zephray/Bric/pcb/pcb.kicad_pcb

## KiCad design pcb/pcb.kicad_pcb (2020-07-26)

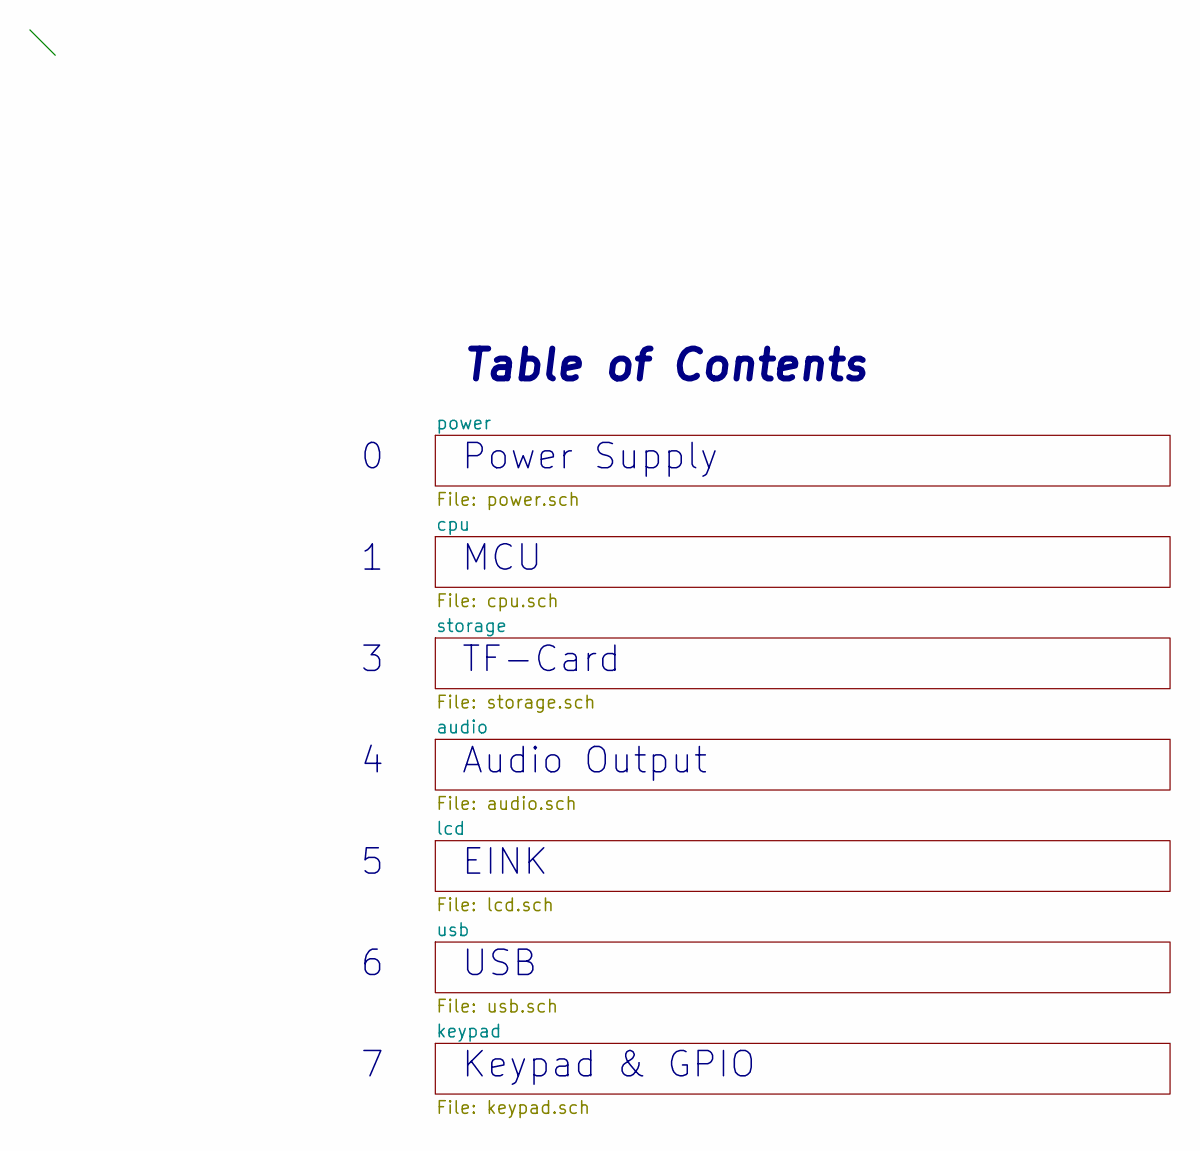
[picture p1: schematic pcb.sch, Bric]

Notes on the sheet:
MCU
EINK
TF-Card
Table of Contents
Power Supply
Audio Output
Keypad & GPIO
USB

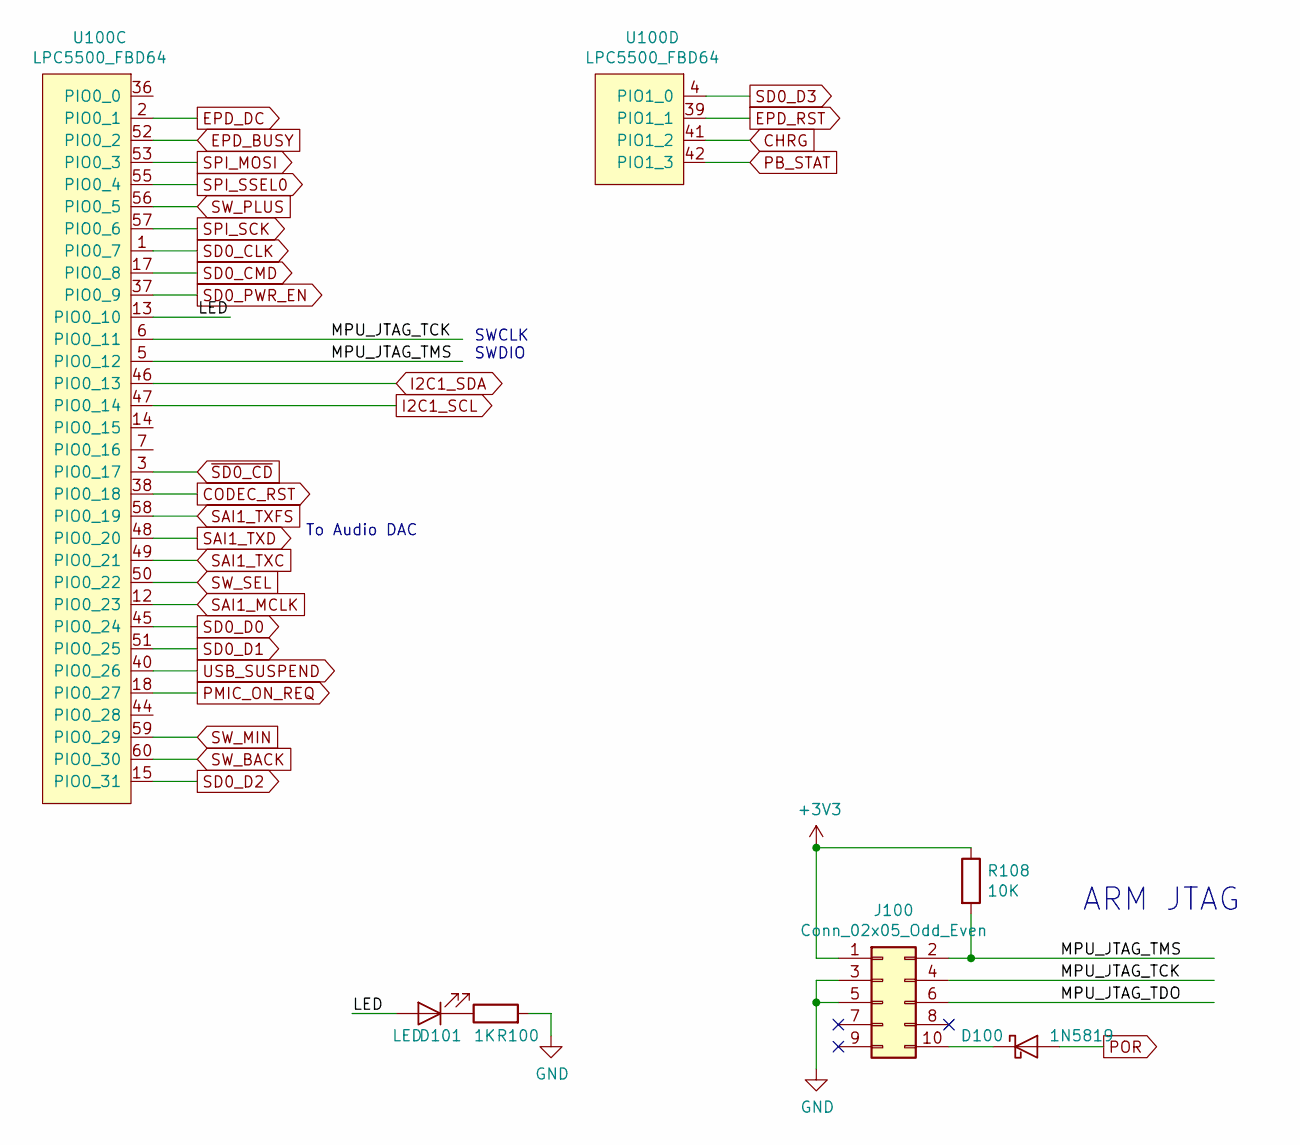
[picture p2: schematic cpu.sch, Bric]

Parts:
D100: 1N5819; D_SOD-123
D101: LED; LED_0603_1608Metric
J100: Conn_02x05_Odd_Even; PinHeader_2x05_P1.27mm_Vertical_SMD
R100: 1K; R_0603_1608Metric
R108: 10K; R_0603_1608Metric
U100: LPC5500_FBD64; LQFP-64-1EP_10x10mm_P0.5mm_EP5x5mm_ThermalVias

Connections:
/cpu/LED: D101.2 (A), U100.13 (PIO0_10)
/cpu/MPU_JTAG_TCK: J100.4, U100.6 (PIO0_11)
/cpu/MPU_JTAG_TMS: J100.2, R108.2, U100.5 (PIO0_12)
CHRG: U100.41 (PIO1_2); also elsewhere on the board
CODEC_RST: U100.38 (PIO0_18); also elsewhere on the board
EPD_BUSY: U100.52 (PIO0_2); also elsewhere on the board
EPD_DC: U100.2 (PIO0_1); also elsewhere on the board
EPD_RST: U100.39 (PIO1_1); also elsewhere on the board
I2C1_SCL: U100.47 (PIO0_14); also elsewhere on the board
I2C1_SDA: U100.46 (PIO0_13); also elsewhere on the board
unnamed: D100.1 (K), J100.10
unnamed: D101.1 (K), R100.1
PB_STAT: U100.42 (PIO1_3); also elsewhere on the board
PMIC_ON_REQ: U100.18 (PIO0_27); also elsewhere on the board
POR: D100.2 (A); also elsewhere on the board
SAI1_MCLK: U100.12 (PIO0_23); also elsewhere on the board
SAI1_TXC: U100.49 (PIO0_21); also elsewhere on the board
SAI1_TXD: U100.48 (PIO0_20); also elsewhere on the board
SAI1_TXFS: U100.58 (PIO0_19); also elsewhere on the board
SD0_CLK: U100.1 (PIO0_7); also elsewhere on the board
SD0_CMD: U100.17 (PIO0_8); also elsewhere on the board
SD0_D0: U100.45 (PIO0_24); also elsewhere on the board
SD0_D1: U100.51 (PIO0_25); also elsewhere on the board
SD0_D2: U100.15 (PIO0_31); also elsewhere on the board
SD0_D3: U100.4 (PIO1_0); also elsewhere on the board
SPI_MOSI: U100.53 (PIO0_3); also elsewhere on the board
SPI_SCK: U100.57 (PIO0_6); also elsewhere on the board
SPI_SSEL0: U100.55 (PIO0_4); also elsewhere on the board
SW_BACK: U100.60 (PIO0_30); also elsewhere on the board
SW_MIN: U100.59 (PIO0_29); also elsewhere on the board
SW_PLUS: U100.56 (PIO0_5); also elsewhere on the board
SW_SEL: U100.50 (PIO0_22); also elsewhere on the board
USB_SUSPEND: U100.40 (PIO0_26); also elsewhere on the board
~SD0_CD: U100.3 (PIO0_17); also elsewhere on the board

Notes on the sheet:
ARM JTAG
To Audio DAC
SWCLK SWDIO

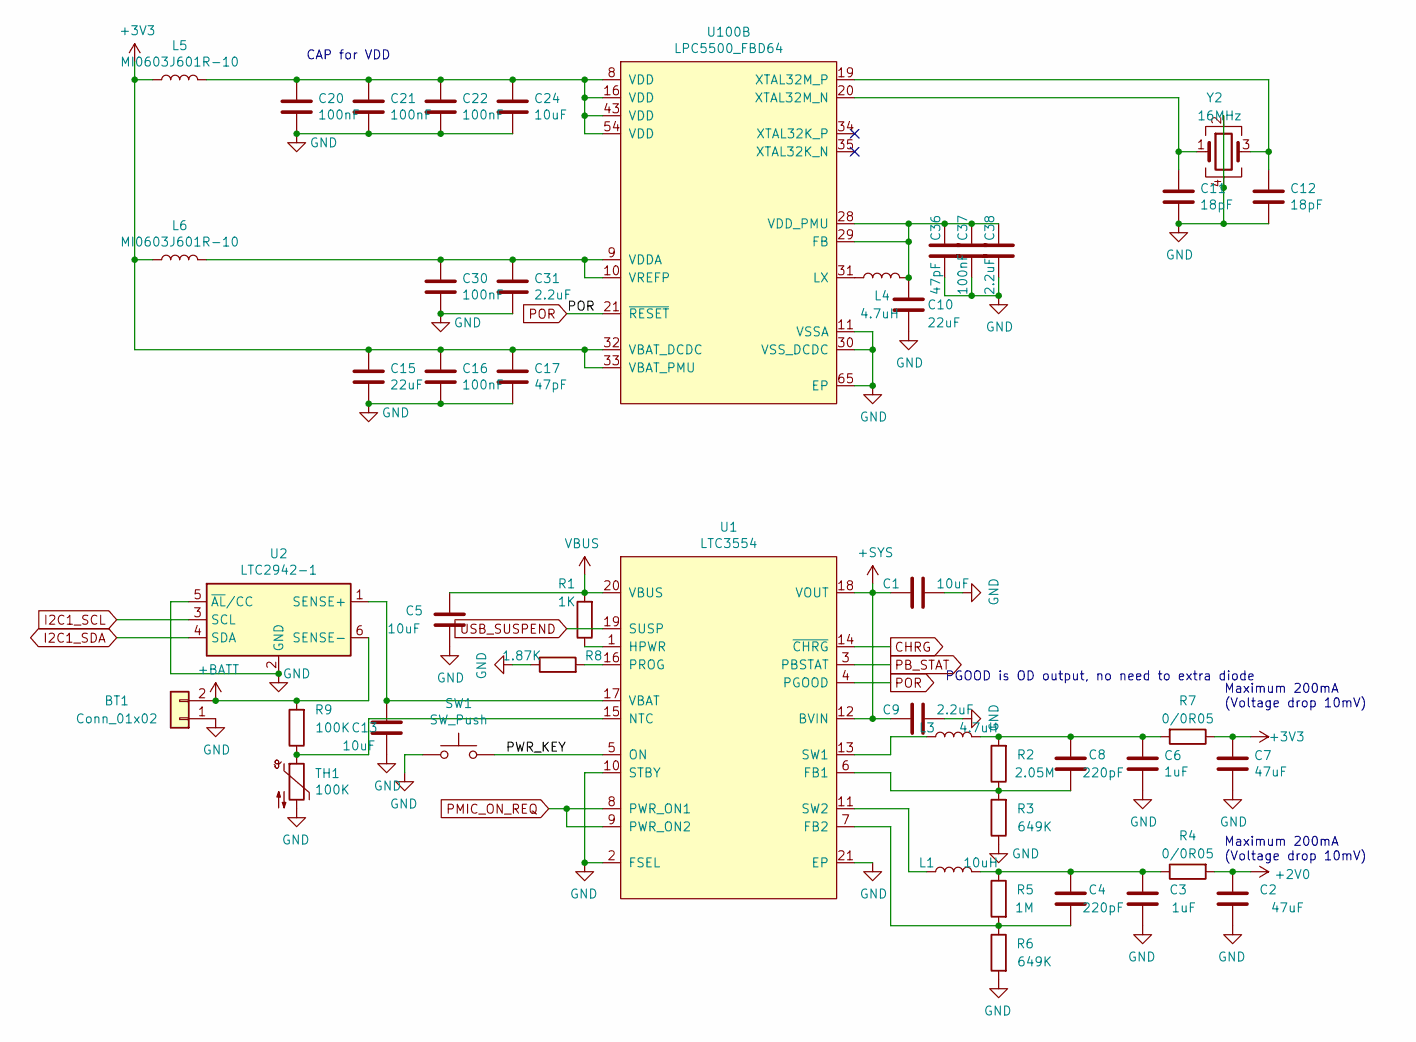
[picture p3: schematic power.sch, Bric]

Parts:
BT1: Conn_01x02; Molex_PicoBlade_53261-0271_1x02-1MP_P1.25mm_Horizontal
C1, C5, C13, C24: 10uF; C_0603_1608Metric
C2, C7: 47uF; C_0805_2012Metric
C3, C6: 1uF; C_0402_1005Metric
C4, C8: 220pF; C_0402_1005Metric
C9, C31, C38: 2.2uF; C_0402_1005Metric
C10, C15: 22uF; C_0603_1608Metric
C11, C12: 18pF; C_0402_1005Metric
C16, C20, C21, C22, C30, C37: 100nF; C_0402_1005Metric
C17, C36: 47pF; C_0402_1005Metric
L1: 10uH; L_Vishay_IHLP-1212
L3, L4: 4.7uH; L_Vishay_IHLP-1212
L5, L6: MI0603J601R-10; L_0603_1608Metric
R1: 1K; R_0603_1608Metric
R2: 2.05M; R_0603_1608Metric
R3, R6: 649K; R_0603_1608Metric
R4, R7: 0/0R05; R_0805_2012Metric
R5: 1M; R_0603_1608Metric
R8: 1.87K; R_0603_1608Metric
R9: 100K; R_0603_1608Metric
SW1: SW_Push; SW_SPST_EVQP7C
TH1: 100K; R_0603_1608Metric
U1: LTC3554; VQFN-20-1EP_3x3mm_P0.4mm_EP1.7x1.7mm_ThermalVias
U2: LTC2942-1; DFN-6-1EP_3x2mm_P0.5mm_EP1.65x1.35mm
U100: LPC5500_FBD64; LQFP-64-1EP_10x10mm_P0.5mm_EP5x5mm_ThermalVias
Y2: 16MHz; Oscillator_SMD_Abracon_ASE-4Pin_3.2x2.5mm

Connections:
+2V0: C2.1, R4.2; also elsewhere on the board
+BATT: BT1.2, R9.2, U2.6 (SENSE-)
+SYS: C1.2, C9.2, U1.12 (BVIN), U1.18 (VOUT); also elsewhere on the board
/power/PWR_KEY: SW1.2, U1.5 (ON)
CHRG: U1.14 (~CHRG); also elsewhere on the board
I2C1_SCL: U2.3 (SCL); also elsewhere on the board
I2C1_SDA: U2.4 (SDA); also elsewhere on the board
unnamed: C3.1, C4.1, L1.1, R4.1, R5.1
unnamed: C4.2, R5.2, R6.1, U1.7 (FB2)
unnamed: C6.1, C8.1, L3.2, R2.2, R7.2
unnamed: C8.2, R2.1, R3.2, U1.6 (FB1)
unnamed: C10.1, C36.1, C37.1, C38.1, L4.2, U100.28 (VDD_PMU), U100.29 (FB)
unnamed: C11.1, U100.20 (XTAL32M_N), Y2.1
unnamed: C12.1, U100.19 (XTAL32M_P), Y2.3
unnamed: C13.1, U1.17 (VBAT), U2.1 (SENSE+)
unnamed: C20.1, C21.1, C22.1, C24.1, L5.2, U100.8 (VDD), U100.16 (VDD), U100.43 (VDD), U100.54 (VDD)
unnamed: C30.1, C31.1, L6.2, U100.9 (VDDA), U100.10 (VREFP)
unnamed: L1.2, U1.11 (SW2)
unnamed: L3.1, U1.13 (SW1)
unnamed: L4.1, U100.31 (LX)
unnamed: R1.1, U1.1 (HPWR)
unnamed: R8.2, U1.16 (PROG)
unnamed: R9.1, TH1.1, U1.15 (NTC)
PB_STAT: U1.3 (PBSTAT); also elsewhere on the board
PMIC_ON_REQ: U1.8 (PWR_ON1), U1.9 (PWR_ON2); also elsewhere on the board
POR: U1.4 (PGOOD), U100.21 (~RESET); also elsewhere on the board
USB_SUSPEND: U1.19 (SUSP); also elsewhere on the board
VBUS: C5.1, R1.2, U1.20 (VBUS); also elsewhere on the board

Notes on the sheet:
Maximum 200mA (Voltage drop 10mV)
CAP for VDD
PGOOD is OD output, no need to extra diode

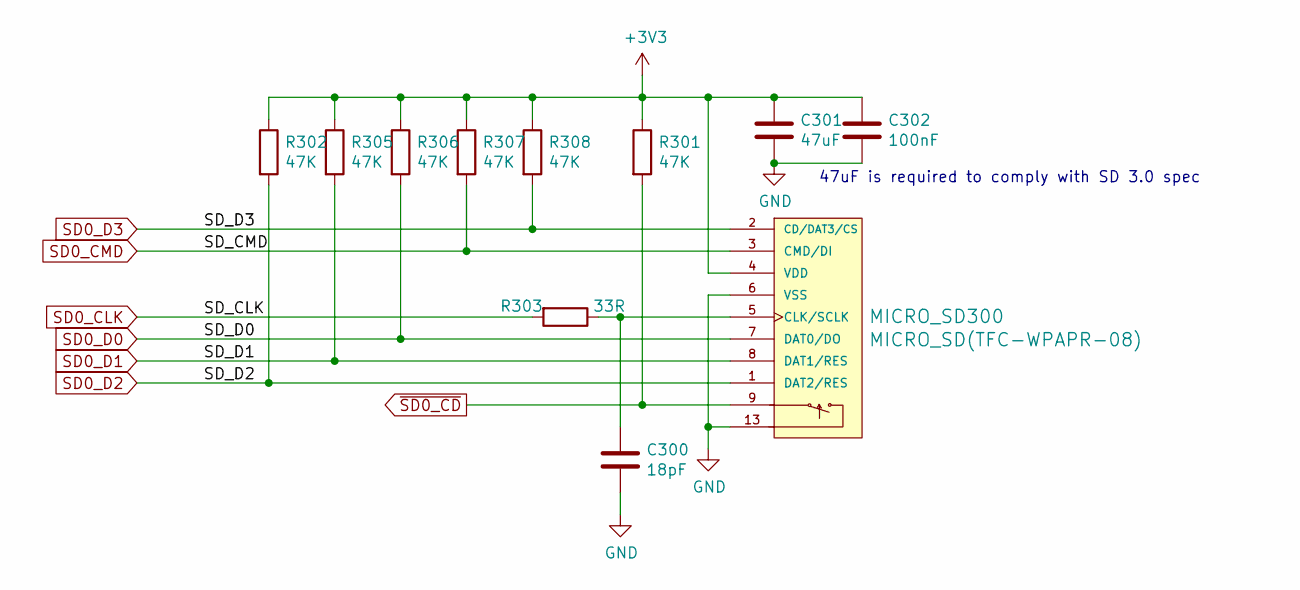
[picture p4: schematic storage.sch, Bric]

Parts:
C300: 18pF; C_0402_1005Metric
C301: 47uF; C_0805_2012Metric
C302: 100nF; C_0402_1005Metric
MICRO_SD300: MICRO_SD(TFC-WPAPR-08); TFC-WPAPR-08
R301, R302, R305, R306, R307, R308: 47K; R_0402_1005Metric
R303: 33R; R_0402_1005Metric

Connections:
unnamed: C300.1, MICRO_SD300.5 (CLK/SCLK), R303.1
SD0_CLK: R303.2; also elsewhere on the board
SD0_CMD: MICRO_SD300.3 (CMD/DI), R307.2; also elsewhere on the board
SD0_D0: MICRO_SD300.7 (DAT0/DO), R306.2; also elsewhere on the board
SD0_D1: MICRO_SD300.8 (DAT1/RES), R305.2; also elsewhere on the board
SD0_D2: MICRO_SD300.1 (DAT2/RES), R302.2; also elsewhere on the board
SD0_D3: MICRO_SD300.2 (CD/DAT3/CS), R308.2; also elsewhere on the board
~SD0_CD: MICRO_SD300.9, R301.2; also elsewhere on the board

Notes on the sheet:
47uF is required to comply with SD 3.0 spec

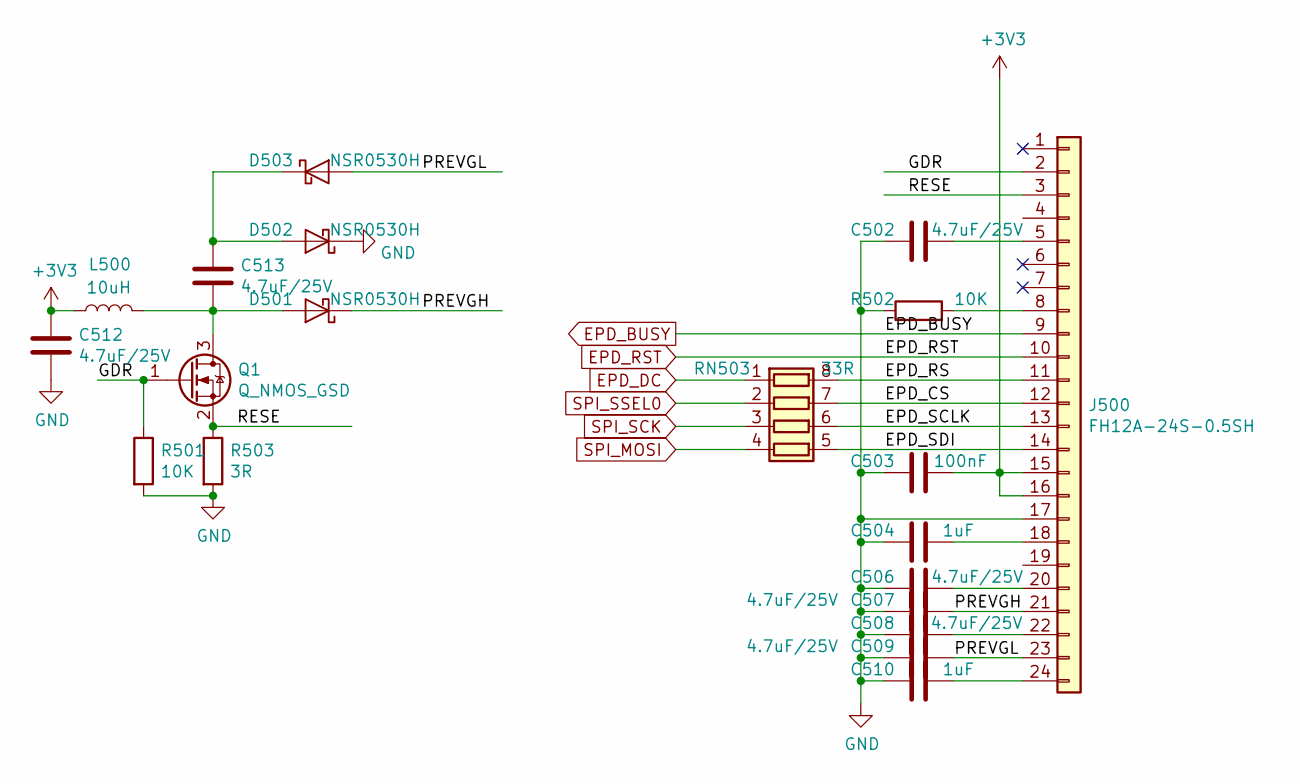
[picture p5: schematic lcd.sch, Bric]

Parts:
C502, C506, C507, C508, C509, C512, C513: 4.7uF/25V; C_0805_2012Metric
C503: 100nF; C_0402_1005Metric
C504, C510: 1uF; C_0603_1608Metric
D501, D502, D503: NSR0530H; D_SOD-323
J500: FH12A-24S-0.5SH; Hirose_FH12A-24S-0.5SH_1x24-1MP_P0.50mm_Horizontal
L500: 10uH; L_Vishay_IHLP-1212
Q1: Q_NMOS_GSD; SOT-323_SC-70
R501, R502: 10K; R_0603_1608Metric
R503: 3R; R_0603_1608Metric
RN503: 33R; R_Array_Convex_4x0402

Connections:
/lcd/EPD_CS: J500.12, RN503.7 (R2.2)
/lcd/EPD_RS: J500.11, RN503.8 (R1.2)
/lcd/EPD_SCLK: J500.13, RN503.6 (R3.2)
/lcd/EPD_SDI: J500.14, RN503.5 (R4.2)
/lcd/GDR: J500.2, Q1.1 (G), R501.1
/lcd/PREVGH: C507.2, D501.1 (K), J500.21
/lcd/PREVGL: C509.1, D503.2 (A), J500.23
/lcd/RESE: J500.3, Q1.2 (S), R503.1
EPD_BUSY: J500.9; also elsewhere on the board
EPD_DC: RN503.1 (R1.1); also elsewhere on the board
EPD_RST: J500.10; also elsewhere on the board
unnamed: C502.2, J500.5
unnamed: C504.2, J500.18
unnamed: C506.2, J500.20
unnamed: C508.1, J500.22
unnamed: C510.1, J500.24
unnamed: C513.1, D501.2 (A), L500.2, Q1.3 (D)
unnamed: C513.2, D502.2 (A), D503.1 (K)
unnamed: J500.8, R502.2
SPI_MOSI: RN503.4 (R4.1); also elsewhere on the board
SPI_SCK: RN503.3 (R3.1); also elsewhere on the board
SPI_SSEL0: RN503.2 (R2.1); also elsewhere on the board

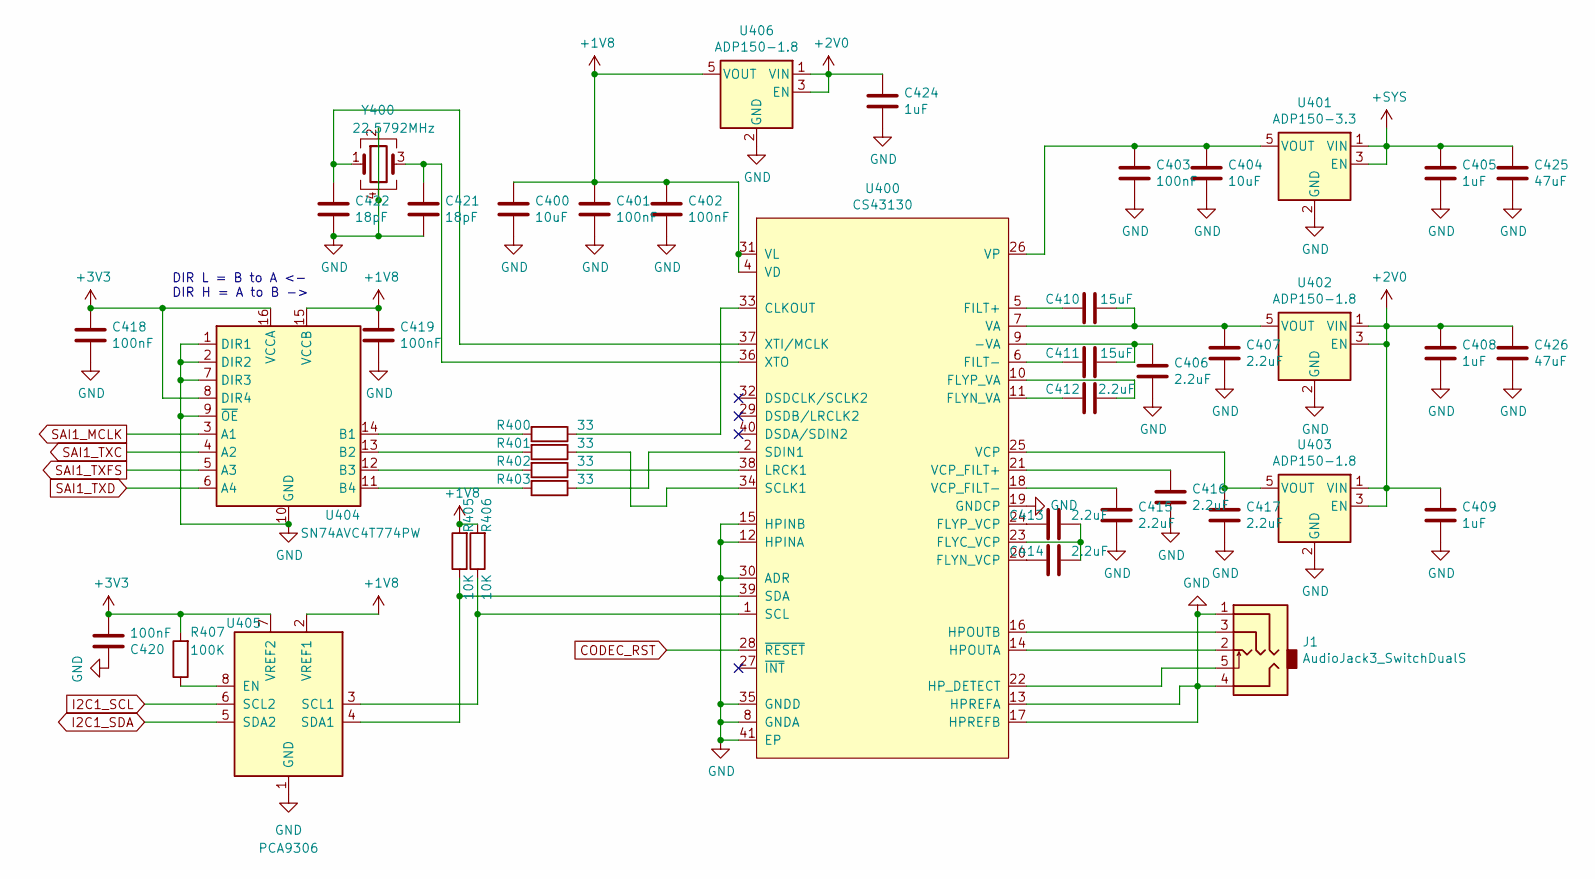
[picture p6: schematic audio.sch, Bric]

Parts:
C400: 10uF; C_0402_1005Metric
C401, C402, C403, C418, C419, C420: 100nF; C_0402_1005Metric
C404: 10uF; C_0603_1608Metric
C405, C408, C409, C424: 1uF; C_0402_1005Metric
C406, C407, C412, C413, C414, C415, C416, C417: 2.2uF; C_0402_1005Metric
C410, C411: 15uF; C_0603_1608Metric
C421, C422: 18pF; C_0402_1005Metric
C425, C426: 47uF; C_0805_2012Metric
J1: AudioJack3_SwitchDualS; Jack_3.5mm_PJ327E_5A
R400, R401, R402, R403: 33; R_0402_1005Metric
R405, R406: 10K; R_0603_1608Metric
R407: 100K; R_0603_1608Metric
U400: CS43130; QFN-40-1EP_5x5mm_P0.4mm_EP3.6x3.6mm_ThermalVias
U401: ADP150-3.3; SOT-23-5
U402, U403, U406: ADP150-1.8; SOT-23-5
U404: SN74AVC4T774PW; TSSOP-16_4.4x5mm_P0.65mm
U405: PCA9306; VSSOP-8_2.3x2mm_P0.5mm
Y400: 22.5792MHz; Oscillator_SMD_Abracon_ASE-4Pin_3.2x2.5mm

Connections:
+1V8: C400.1, C401.1, C402.1, C419.1, R405.2, R406.2, U400.4 (VD), U400.31 (VL), U404.15 (VCCB), U405.2 (VREF1), U406.5 (VOUT)
+2V0: C408.1, C409.1, C424.1, C426.1, U402.1 (VIN), U402.3 (EN), U403.1 (VIN), U403.3 (EN), U406.1 (VIN), U406.3 (EN); also elsewhere on the board
+SYS: C405.1, C425.1, U401.1 (VIN), U401.3 (EN); also elsewhere on the board
CODEC_RST: U400.28 (~RESET); also elsewhere on the board
I2C1_SCL: U405.6 (SCL2); also elsewhere on the board
I2C1_SDA: U405.5 (SDA2); also elsewhere on the board
unnamed: C403.1, C404.1, U400.26 (VP), U401.5 (VOUT)
unnamed: C406.1, C411.1, U400.9 (-VA)
unnamed: C407.1, C410.1, U400.7 (VA), U402.5 (VOUT)
unnamed: C410.2, U400.5 (FILT+)
unnamed: C411.2, U400.6 (FILT-)
unnamed: C412.1, U400.10 (FLYP_VA)
unnamed: C412.2, U400.11 (FLYN_VA)
unnamed: C413.1, C414.1, U400.23 (FLYC_VCP)
unnamed: C413.2, U400.24 (FLYP_VCP)
unnamed: C414.2, U400.20 (FLYN_VCP)
unnamed: C415.1, U400.18 (VCP_FILT-)
unnamed: C416.1, U400.21 (VCP_FILT+)
unnamed: C417.1, U400.25 (VCP), U403.5 (VOUT)
unnamed: C421.1, U400.36 (XTO), Y400.3
unnamed: C422.1, U400.37 (XTI/MCLK), Y400.1
unnamed: J1.2, U400.14 (HPOUTA)
unnamed: J1.3, U400.16 (HPOUTB)
unnamed: J1.5, U400.22 (HP_DETECT)
unnamed: R400.1, U400.33 (CLKOUT)
unnamed: R400.2, U404.14 (B1)
unnamed: R401.1, U400.34 (SCLK1)
unnamed: R401.2, U404.13 (B2)
unnamed: R402.1, U400.38 (LRCK1)
unnamed: R402.2, U404.12 (B3)
unnamed: R403.1, U400.2 (SDIN1)
unnamed: R403.2, U404.11 (B4)
unnamed: R405.1, U400.39 (SDA), U405.4 (SDA1)
unnamed: R406.1, U400.1 (SCL), U405.3 (SCL1)
unnamed: R407.1, U405.8 (EN)
SAI1_MCLK: U404.3 (A1); also elsewhere on the board
SAI1_TXC: U404.4 (A2); also elsewhere on the board
SAI1_TXD: U404.6 (A4); also elsewhere on the board
SAI1_TXFS: U404.5 (A3); also elsewhere on the board

Notes on the sheet:
DIR L = B to A <- DIR H = A to B ->

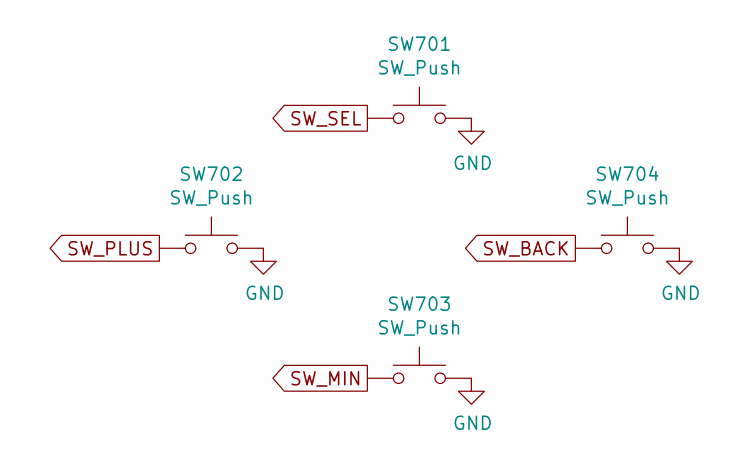
[picture p7: schematic keypad.sch, Bric]

Parts:
SW701, SW702, SW703, SW704: SW_Push; SW_SPST_EVQP7C

Connections:
SW_BACK: SW704.1; also elsewhere on the board
SW_MIN: SW703.1; also elsewhere on the board
SW_PLUS: SW702.1; also elsewhere on the board
SW_SEL: SW701.1; also elsewhere on the board

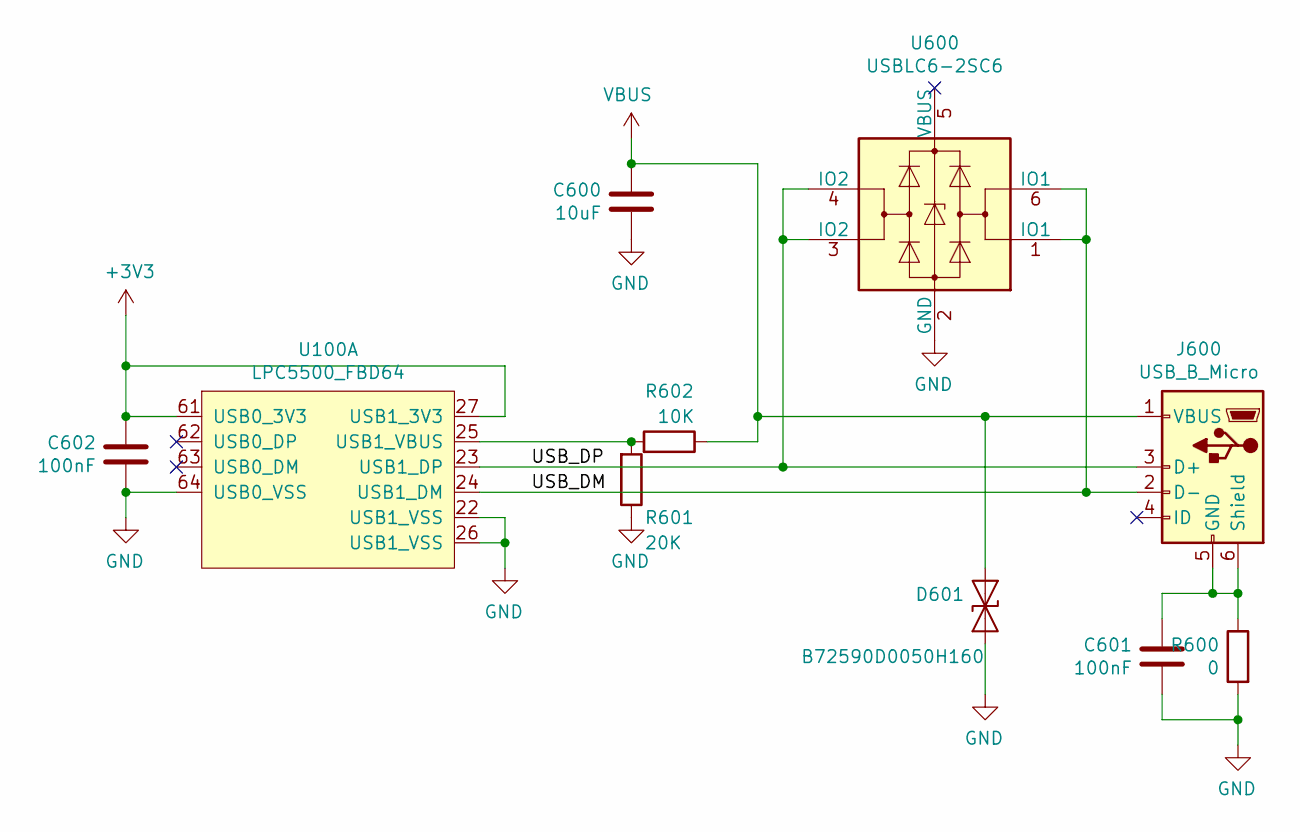
[picture p8: schematic usb.sch, Bric]

Parts:
C600: 10uF; C_0603_1608Metric
C601: 100nF; C_0805_2012Metric
C602: 100nF; C_0402_1005Metric
D601: B72590D0050H160; D_0402_1005Metric
J600: USB_B_Micro; USB_Micro-B_Amphenol_10103594-0001LF_Horizontal
R600: 0; R_0805_2012Metric
R601: 20K; R_0603_1608Metric
R602: 10K; R_0603_1608Metric
U100: LPC5500_FBD64; LQFP-64-1EP_10x10mm_P0.5mm_EP5x5mm_ThermalVias
U600: USBLC6-2SC6; SOT-23-6

Connections:
/usb/USB_DM: J600.2 (D-), U100.24 (USB1_DM), U600.1 (IO1), U600.6 (IO1)
/usb/USB_DP: J600.3 (D+), U100.23 (USB1_DP), U600.3 (IO2), U600.4 (IO2)
unnamed: C601.1, J600.5 (GND), J600.6 (Shield), R600.1
unnamed: R601.2, R602.2, U100.25 (USB1_VBUS)
VBUS: C600.1, D601.1 (A1), J600.1 (VBUS), R602.1; also elsewhere on the board

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
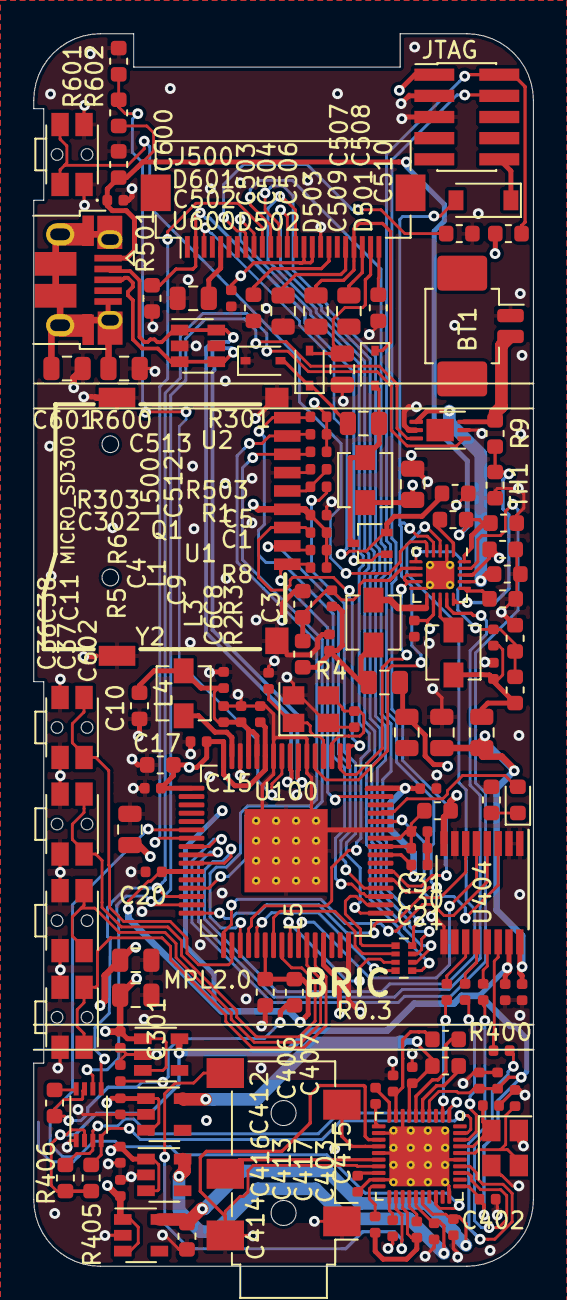
[picture p9: board pcb.kicad_pcb from above]

Board: 4 copper layers, 30.0 x 74.0 mm, 137 parts (0 on the bottom side), 108 nets.
