zephray/Bric/bringup/source/audio_speaker.c

/*
 * Copyright (c) 2015 - 2016, Freescale Semiconductor, Inc.
 * Copyright 2016 - 2017,2019 NXP
 * All rights reserved.
 *
 * SPDX-License-Identifier: BSD-3-Clause
 */

#include "usb_device_config.h"
#include "usb.h"
#include "usb_device.h"
#include "usb_device_class.h"
#include "usb_device_audio.h"

#include "usb_device_ch9.h"
#include "usb_device_descriptor.h"

#include "audio_speaker.h"
#include "fsl_device_registers.h"
#include "clock_config.h"
#include "board.h"
#include <stdio.h>
#include <stdlib.h>
#if (defined(FSL_FEATURE_SOC_SYSMPU_COUNT) && (FSL_FEATURE_SOC_SYSMPU_COUNT > 0U))
#include "fsl_sysmpu.h"
#endif /* FSL_FEATURE_SOC_SYSMPU_COUNT */


#if ((defined FSL_FEATURE_SOC_USBPHY_COUNT) && (FSL_FEATURE_SOC_USBPHY_COUNT > 0U))
#include "usb_phy.h"
#endif
#include "pin_mux.h"
#include "fsl_i2c.h"
#include "fsl_i2s.h"
#include "fsl_i2s_dma.h"
#include "fsl_power.h"
/*******************************************************************************
 * Definitions
 ******************************************************************************/
#define DEMO_I2S_MASTER_CLOCK_FREQUENCY (11289600)
#define DEMO_I2S_TX (I2S7)
#define DEMO_DMA (DMA0)
#define DEMO_I2S_SAMPLE_SIZE (16)
#define DEMO_I2S_FRAME_SIZE (64)
#define DEMO_I2S_TX_CHANNEL (19)
#define I2S_CLOCK_DIVIDER (DEMO_I2S_MASTER_CLOCK_FREQUENCY / AUDIO_SAMPLING_RATE / DEMO_I2S_FRAME_SIZE)

#define AUDIO_SAMPLING_RATE_TO_10_14 (((AUDIO_SAMPLING_RATE/1000)<<14)|((AUDIO_SAMPLING_RATE%1000)<<4))
//#define AUDIO_SAMPLING_RATE_TO_16_16 (AUDIO_SAMPLING_RATE_KHZ << 13)
#if USBCFG_AUDIO_CLASS_2_0
/* change 10.10 data to 10.14 or 16.16 (12.13) */
#define AUDIO_UPDATE_FEEDBACK_DATA(m, n)                  \
    if (USB_SPEED_HIGH == g_UsbDeviceAudioSpeaker.speed)  \
    {                                                     \
        m[0] = (((n & 0x000003FFu) << 3) & 0xFFu);        \
        m[1] = ((((n & 0x000003FFu) << 3) >> 8) & 0xFFu); \
        m[2] = (((n & 0x000FFC00u) >> 10) & 0xFFu);       \
        m[3] = (((n & 0x000FFC00u) >> 18) & 0xFFu);       \
    }                                                     \
    else                                                  \
    {                                                     \
        m[0] = ((n << 4) & 0xFFU);                        \
        m[1] = (((n << 4) >> 8U) & 0xFFU);                \
        m[2] = (((n << 4) >> 16U) & 0xFFU);               \
    }
#else
/* change 10.10 data to 10.14 */
#define AUDIO_UPDATE_FEEDBACK_DATA(m, n)    \
    {                                       \
        m[0] = ((n << 4) & 0xFFU);          \
        m[1] = (((n << 4) >> 8U) & 0xFFU);  \
        m[2] = (((n << 4) >> 16U) & 0xFFU); \
    }
#endif

#define USB_AUDIO_ENTER_CRITICAL() \
                                   \
    OSA_SR_ALLOC();            \
                                   \
    OSA_ENTER_CRITICAL()

#define USB_AUDIO_EXIT_CRITICAL() OSA_EXIT_CRITICAL()
/*******************************************************************************
 * Prototypes
 ******************************************************************************/
void BOARD_InitHardware(void);
void USB_DeviceClockInit(void);
void USB_DeviceIsrEnable(void);
#if USB_DEVICE_CONFIG_USE_TASK
void USB_DeviceTaskFn(void *deviceHandle);
#endif

usb_status_t USB_DeviceAudioCallback(class_handle_t handle, uint32_t event, void *param);
usb_status_t USB_DeviceCallback(usb_device_handle handle, uint32_t event, void *param);

extern void Init_Board_Audio(void);
#if defined(USB_DEVICE_AUDIO_USE_SYNC_MODE) && (USB_DEVICE_AUDIO_USE_SYNC_MODE > 0U)
extern void SCTIMER_CaptureInit(void);
#endif
/*******************************************************************************
 * Variables
 ******************************************************************************/
extern usb_audio_speaker_struct_t g_UsbDeviceAudioSpeaker;
extern uint8_t audioPlayDataBuff[AUDIO_SPEAKER_DATA_WHOLE_BUFFER_LENGTH * FS_ISO_OUT_ENDP_PACKET_SIZE];
static i2s_config_t s_TxConfig;
static i2s_dma_handle_t s_TxHandle;
static dma_handle_t s_DmaTxHandle;
static i2s_transfer_t s_TxTransfer;

USB_DMA_NONINIT_DATA_ALIGN(USB_DATA_ALIGN_SIZE)
static uint8_t audioPlayDMATempBuff[FS_ISO_OUT_ENDP_PACKET_SIZE];
USB_DMA_NONINIT_DATA_ALIGN(USB_DATA_ALIGN_SIZE)
uint8_t audioPlayDataBuff[AUDIO_SPEAKER_DATA_WHOLE_BUFFER_LENGTH * FS_ISO_OUT_ENDP_PACKET_SIZE];
#if defined(USB_DEVICE_AUDIO_USE_SYNC_MODE) && (USB_DEVICE_AUDIO_USE_SYNC_MODE > 0U)
USB_DMA_NONINIT_DATA_ALIGN(USB_DATA_ALIGN_SIZE)
uint8_t audioPlayPacket[FS_ISO_OUT_ENDP_PACKET_SIZE];
#else
USB_DMA_NONINIT_DATA_ALIGN(USB_DATA_ALIGN_SIZE)
uint8_t audioPlayPacket[FS_ISO_OUT_ENDP_PACKET_SIZE + AUDIO_FORMAT_CHANNELS * AUDIO_FORMAT_SIZE];
USB_DMA_NONINIT_DATA_ALIGN(USB_DATA_ALIGN_SIZE)
uint8_t audioFeedBackBuffer[4];
#endif

extern usb_device_class_struct_t g_UsbDeviceAudioClass;

/* Default value of audio generator device struct */
USB_DMA_INIT_DATA_ALIGN(USB_DATA_ALIGN_SIZE)
usb_audio_speaker_struct_t g_UsbDeviceAudioSpeaker = {
    .deviceHandle = NULL,
    .audioHandle  = (class_handle_t)NULL,
#if defined(USB_DEVICE_AUDIO_USE_SYNC_MODE) && (USB_DEVICE_AUDIO_USE_SYNC_MODE > 0U)
    .currentStreamOutMaxPacketSize = (FS_ISO_OUT_ENDP_PACKET_SIZE),
#else
    .currentStreamOutMaxPacketSize = (FS_ISO_OUT_ENDP_PACKET_SIZE + AUDIO_FORMAT_CHANNELS * AUDIO_FORMAT_SIZE),
    .currentFeedbackMaxPacketSize  = FS_ISO_FEEDBACK_ENDP_PACKET_SIZE,
#endif
    .attach               = 0U,
    .copyProtect          = 0x01U,
    .curMute              = 0x00U,
    .curVolume            = {0x1fU, 0x00U},
    .minVolume            = {0x00U, 0x00U},
    .maxVolume            = {0xffU, 0x00U},
    .resVolume            = {0x01U, 0x00U},
    .curBass              = 0x00U,
    .minBass              = 0x80U,
    .maxBass              = 0x7FU,
    .resBass              = 0x01U,
    .curMid               = 0x00U,
    .minMid               = 0x80U,
    .maxMid               = 0x7FU,
    .resMid               = 0x01U,
    .curTreble            = 0x01U,
    .minTreble            = 0x80U,
    .maxTreble            = 0x7FU,
    .resTreble            = 0x01U,
    .curAutomaticGain     = 0x01U,
    .curDelay             = {0x00U, 0x40U},
    .minDelay             = {0x00U, 0x00U},
    .maxDelay             = {0xFFU, 0xFFU},
    .resDelay             = {0x00U, 0x01U},
    .curLoudness          = 0x01U,
    .curSamplingFrequency = {0x00U, 0x00U, 0x01U},
    .minSamplingFrequency = {0x00U, 0x00U, 0x01U},
    .maxSamplingFrequency = {0x00U, 0x00U, 0x01U},
    .resSamplingFrequency = {0x00U, 0x00U, 0x01U},
#if USBCFG_AUDIO_CLASS_2_0
    .curMute20          = 0U,
    .curClockValid      = 1U,
    .curVolume20        = {0x00U, 0x1FU},
    .curSampleFrequency = 48000U, /* This should be changed to 48000 if sampling rate is 48k */
    .freqControlRange   = {1U, 48000U, 48000U, 0U},
    .volumeControlRange = {1U, 0x8001U, 0x7FFFU, 1U},
#endif
    .speed                  = USB_SPEED_HIGH,
    .tdReadNumberPlay       = 0,
    .tdWriteNumberPlay      = 0,
    .audioSendCount         = 0,
    .lastAudioSendCount     = 0,
    .usbRecvCount           = 0,
    .audioSendTimes         = 0,
    .usbRecvTimes           = 0,
    .startPlay              = 0,
    .startPlayHalfFull      = 0,
    .speakerIntervalCount   = 0,
    .speakerReservedSpace   = 0,
    .timesFeedbackCalculate = 0,
    .speakerDetachOrNoInput = 0,
#if defined(USB_DEVICE_AUDIO_USE_SYNC_MODE) && (USB_DEVICE_AUDIO_USE_SYNC_MODE > 0U)
    .audioPllTicksPrev   = 0,
    .audioPllTicksDiff   = 0,
    .audioPllTicksEma    = AUDIO_PLL_USB1_SOF_INTERVAL_COUNT,
    .audioPllTickEmaFrac = 0,
    .audioPllStep        = AUDIO_PLL_FRACTIONAL_CHANGE_STEP,
#endif
};

/* USB device class information */
static usb_device_class_config_struct_t s_audioConfig[1] = {{
    USB_DeviceAudioCallback,
    (class_handle_t)NULL,
    &g_UsbDeviceAudioClass,
}};

/* USB device class configuration information */
static usb_device_class_config_list_struct_t s_audioConfigList = {
    s_audioConfig,
    USB_DeviceCallback,
    1U,
};

/*******************************************************************************
 * Code
 ******************************************************************************/
extern void WM8904_USB_Audio_Init(void *I2CBase);
void WM8904_Config_Audio_Formats(uint32_t samplingRate);

void BOARD_DMA_EDMA_Set_AudioFormat(void)
{
    return;
}

void BOARD_DMA_EDMA_Enable_Audio_Interrupts(void)
{
    return;
}


void BOARD_Codec_Init()
{
   // TODO: Codec init
}

void I2S_USB_Audio_TxInit(I2S_Type *SAIBase)
{
    /*
     * masterSlave = kI2S_MasterSlaveNormalMaster;
     * mode = kI2S_ModeI2sClassic;
     * rightLow = false;
     * leftJust = false;
     * pdmData = false;
     * sckPol = false;
     * wsPol = false;
     * divider = 1;
     * oneChannel = false;
     * dataLength = 16;
     * frameLength = 32;
     * position = 0;
     * watermark = 4;
     * txEmptyZero = true;
     * pack48 = false;
     */
    I2S_TxGetDefaultConfig(&s_TxConfig);
    s_TxConfig.masterSlave = kI2S_MasterSlaveNormalSlave;
    s_TxConfig.divider = I2S_CLOCK_DIVIDER;
    s_TxConfig.dataLength = DEMO_I2S_SAMPLE_SIZE;
    s_TxConfig.frameLength = DEMO_I2S_FRAME_SIZE;
    I2S_TxInit(DEMO_I2S_TX, &s_TxConfig);
}

void BOARD_USB_Audio_TxInit(uint32_t samplingRate)
{
    I2S_USB_Audio_TxInit(DEMO_I2S_TX);
}

static void TxCallback(I2S_Type *base, i2s_dma_handle_t *handle, status_t completionStatus, void *userData)
{
    if ((g_UsbDeviceAudioSpeaker.audioSendTimes >= g_UsbDeviceAudioSpeaker.usbRecvTimes) &&
        (g_UsbDeviceAudioSpeaker.startPlayHalfFull == 1))
    {
        g_UsbDeviceAudioSpeaker.startPlayHalfFull      = 0;
        g_UsbDeviceAudioSpeaker.speakerDetachOrNoInput = 1;
    }
    if (g_UsbDeviceAudioSpeaker.startPlayHalfFull)
    {
        s_TxTransfer.dataSize = FS_ISO_OUT_ENDP_PACKET_SIZE;
        s_TxTransfer.data     = audioPlayDataBuff + g_UsbDeviceAudioSpeaker.tdWriteNumberPlay;
        g_UsbDeviceAudioSpeaker.audioSendCount += FS_ISO_OUT_ENDP_PACKET_SIZE;
        g_UsbDeviceAudioSpeaker.audioSendTimes++;
        g_UsbDeviceAudioSpeaker.tdWriteNumberPlay += FS_ISO_OUT_ENDP_PACKET_SIZE;
        if (g_UsbDeviceAudioSpeaker.tdWriteNumberPlay >=
            AUDIO_SPEAKER_DATA_WHOLE_BUFFER_LENGTH * FS_ISO_OUT_ENDP_PACKET_SIZE)
        {
            g_UsbDeviceAudioSpeaker.tdWriteNumberPlay = 0;
        }
    }
    else
    {
        s_TxTransfer.dataSize = FS_ISO_OUT_ENDP_PACKET_SIZE;
        s_TxTransfer.data     = audioPlayDMATempBuff;
    }
    I2S_TxTransferSendDMA(base, handle, s_TxTransfer);
}

void BOARD_DMA_EDMA_Config()
{
    DMA_Init(DEMO_DMA);

    DMA_EnableChannel(DEMO_DMA, DEMO_I2S_TX_CHANNEL);
    DMA_SetChannelPriority(DEMO_DMA, DEMO_I2S_TX_CHANNEL, kDMA_ChannelPriority3);
}

void BOARD_Create_Audio_DMA_EDMA_Handle()
{
    DMA_CreateHandle(&s_DmaTxHandle, DEMO_DMA, DEMO_I2S_TX_CHANNEL);
}

void BOARD_DMA_EDMA_Start()
{
    s_TxTransfer.dataSize = FS_ISO_OUT_ENDP_PACKET_SIZE;
    s_TxTransfer.data     = audioPlayDMATempBuff;

    I2S_TxTransferCreateHandleDMA(DEMO_I2S_TX, &s_TxHandle, &s_DmaTxHandle, TxCallback, (void *)&s_TxTransfer);
    /* need to queue two transmit buffers so when the first one
     * finishes transfer, the other immediatelly starts */
    I2S_TxTransferSendDMA(DEMO_I2S_TX, &s_TxHandle, s_TxTransfer);
    I2S_TxTransferSendDMA(DEMO_I2S_TX, &s_TxHandle, s_TxTransfer);
}

/*Initialize audio interface and codec.*/
void Init_Board_Audio(void)
{
    usb_echo("Init Audio I2S and CODEC\r\n");

    BOARD_USB_Audio_TxInit(AUDIO_SAMPLING_RATE);
    BOARD_Codec_Init();
    BOARD_DMA_EDMA_Config();
    BOARD_Create_Audio_DMA_EDMA_Handle();
    BOARD_DMA_EDMA_Start();
}

#if (defined(USB_DEVICE_CONFIG_LPCIP3511FS) && (USB_DEVICE_CONFIG_LPCIP3511FS > 0U))
void USB0_IRQHandler(void)
{
    USB_DeviceLpcIp3511IsrFunction(g_UsbDeviceAudioSpeaker.deviceHandle);
}
#endif
#if (defined(USB_DEVICE_CONFIG_LPCIP3511HS) && (USB_DEVICE_CONFIG_LPCIP3511HS > 0U))
void USB1_IRQHandler(void)
{
    USB_DeviceLpcIp3511IsrFunction(g_UsbDeviceAudioSpeaker.deviceHandle);
}
#endif
void USB_DeviceClockInit(void)
{
#if defined(USB_DEVICE_CONFIG_LPCIP3511FS) && (USB_DEVICE_CONFIG_LPCIP3511FS > 0U)
    /* enable USB IP clock */
    CLOCK_EnableUsbfs0DeviceClock(kCLOCK_UsbfsSrcFro, CLOCK_GetFroHfFreq());
    ANACTRL->FRO192M_CTRL = (ANACTRL->FRO192M_CTRL & ~(ANACTRL_FRO192M_CTRL_USBCLKADJ_MASK));
#if defined(FSL_FEATURE_USB_USB_RAM) && (FSL_FEATURE_USB_USB_RAM)
    for (int i = 0; i < FSL_FEATURE_USB_USB_RAM; i++)
    {
        ((uint8_t *)FSL_FEATURE_USB_USB_RAM_BASE_ADDRESS)[i] = 0x00U;
    }
#endif

#endif
#if defined(USB_DEVICE_CONFIG_LPCIP3511HS) && (USB_DEVICE_CONFIG_LPCIP3511HS > 0U)
    /* enable USB IP clock */
    CLOCK_EnableUsbhs0PhyPllClock(kCLOCK_UsbPhySrcExt, 16000000U);
    CLOCK_EnableUsbhs0DeviceClock(kCLOCK_UsbSrcUnused, 0U);
    USB_EhciPhyInit(CONTROLLER_ID, 24000000U, NULL);
#if defined(FSL_FEATURE_USBHSD_USB_RAM) && (FSL_FEATURE_USBHSD_USB_RAM)
    for (int i = 0; i < FSL_FEATURE_USBHSD_USB_RAM; i++)
    {
        ((uint8_t *)FSL_FEATURE_USBHSD_USB_RAM_BASE_ADDRESS)[i] = 0x00U;
    }
#endif
#endif
}
void USB_DeviceIsrEnable(void)
{
    uint8_t irqNumber;
#if defined(USB_DEVICE_CONFIG_LPCIP3511FS) && (USB_DEVICE_CONFIG_LPCIP3511FS > 0U)
    uint8_t usbDeviceIP3511Irq[] = USB_IRQS;
    irqNumber                    = usbDeviceIP3511Irq[CONTROLLER_ID - kUSB_ControllerLpcIp3511Fs0];
#endif
#if defined(USB_DEVICE_CONFIG_LPCIP3511HS) && (USB_DEVICE_CONFIG_LPCIP3511HS > 0U)
    uint8_t usbDeviceIP3511Irq[] = USBHSD_IRQS;
    irqNumber                    = usbDeviceIP3511Irq[CONTROLLER_ID - kUSB_ControllerLpcIp3511Hs0];
#endif
    /* Install isr, set priority, and enable IRQ. */
    NVIC_SetPriority((IRQn_Type)irqNumber, USB_DEVICE_INTERRUPT_PRIORITY);
    EnableIRQ((IRQn_Type)irqNumber);
}
#if USB_DEVICE_CONFIG_USE_TASK
void USB_DeviceTaskFn(void *deviceHandle)
{
#if defined(USB_DEVICE_CONFIG_LPCIP3511FS) && (USB_DEVICE_CONFIG_LPCIP3511FS > 0U)
    USB_DeviceLpcIp3511TaskFunction(deviceHandle);
#endif
#if defined(USB_DEVICE_CONFIG_LPCIP3511HS) && (USB_DEVICE_CONFIG_LPCIP3511HS > 0U)
    USB_DeviceLpcIp3511TaskFunction(deviceHandle);
#endif
}
#endif

/*!
 * @brief Audio class specific request function.
 *
 * This function handles the Audio class specific requests.
 *
 * @param handle		  The Audio class handle.
 * @param event 		  The Audio class event type.
 * @param param 		  The parameter of the class specific request.
 *
 * @return A USB error code or kStatus_USB_Success.
 */
usb_status_t USB_DeviceAudioRequest(class_handle_t handle, uint32_t event, void *param)
{
    usb_device_control_request_struct_t *request = (usb_device_control_request_struct_t *)param;
    usb_status_t error                           = kStatus_USB_Success;

    switch (event)
    {
        case USB_DEVICE_AUDIO_GET_CUR_MUTE_CONTROL:
            request->buffer = &g_UsbDeviceAudioSpeaker.curMute;
            request->length = sizeof(g_UsbDeviceAudioSpeaker.curMute);
            break;
        case USB_DEVICE_AUDIO_GET_CUR_VOLUME_CONTROL:
            request->buffer = g_UsbDeviceAudioSpeaker.curVolume;
            request->length = sizeof(g_UsbDeviceAudioSpeaker.curVolume);
            break;
        case USB_DEVICE_AUDIO_GET_CUR_BASS_CONTROL:
            request->buffer = &g_UsbDeviceAudioSpeaker.curBass;
            request->length = sizeof(g_UsbDeviceAudioSpeaker.curBass);
            break;
        case USB_DEVICE_AUDIO_GET_CUR_MID_CONTROL:
            request->buffer = &g_UsbDeviceAudioSpeaker.curMid;
            request->length = sizeof(g_UsbDeviceAudioSpeaker.curMid);
            break;
        case USB_DEVICE_AUDIO_GET_CUR_TREBLE_CONTROL:
            request->buffer = &g_UsbDeviceAudioSpeaker.curTreble;
            request->length = sizeof(g_UsbDeviceAudioSpeaker.curTreble);
            break;
        case USB_DEVICE_AUDIO_GET_CUR_AUTOMATIC_GAIN_CONTROL:
            request->buffer = &g_UsbDeviceAudioSpeaker.curAutomaticGain;
            request->length = sizeof(g_UsbDeviceAudioSpeaker.curAutomaticGain);
            break;
        case USB_DEVICE_AUDIO_GET_CUR_DELAY_CONTROL:
            request->buffer = g_UsbDeviceAudioSpeaker.curDelay;
            request->length = sizeof(g_UsbDeviceAudioSpeaker.curDelay);
            break;
        case USB_DEVICE_AUDIO_GET_CUR_SAMPLING_FREQ_CONTROL:
            request->buffer = g_UsbDeviceAudioSpeaker.curSamplingFrequency;
            request->length = sizeof(g_UsbDeviceAudioSpeaker.curSamplingFrequency);
            break;
        case USB_DEVICE_AUDIO_GET_MIN_VOLUME_CONTROL:
            request->buffer = g_UsbDeviceAudioSpeaker.minVolume;
            request->length = sizeof(g_UsbDeviceAudioSpeaker.minVolume);
            break;
        case USB_DEVICE_AUDIO_GET_MIN_BASS_CONTROL:
            request->buffer = &g_UsbDeviceAudioSpeaker.minBass;
            request->length = sizeof(g_UsbDeviceAudioSpeaker.minBass);
            break;
        case USB_DEVICE_AUDIO_GET_MIN_MID_CONTROL:
            request->buffer = &g_UsbDeviceAudioSpeaker.minMid;
            request->length = sizeof(g_UsbDeviceAudioSpeaker.minMid);
            break;
        case USB_DEVICE_AUDIO_GET_MIN_TREBLE_CONTROL:
            request->buffer = &g_UsbDeviceAudioSpeaker.minTreble;
            request->length = sizeof(g_UsbDeviceAudioSpeaker.minTreble);
            break;
        case USB_DEVICE_AUDIO_GET_MIN_DELAY_CONTROL:
            request->buffer = g_UsbDeviceAudioSpeaker.minDelay;
            request->length = sizeof(g_UsbDeviceAudioSpeaker.minDelay);
            break;
        case USB_DEVICE_AUDIO_GET_MIN_SAMPLING_FREQ_CONTROL:
            request->buffer = g_UsbDeviceAudioSpeaker.minSamplingFrequency;
            request->length = sizeof(g_UsbDeviceAudioSpeaker.minSamplingFrequency);
            break;
        case USB_DEVICE_AUDIO_GET_MAX_VOLUME_CONTROL:
            request->buffer = g_UsbDeviceAudioSpeaker.maxVolume;
            request->length = sizeof(g_UsbDeviceAudioSpeaker.maxVolume);
            break;
        case USB_DEVICE_AUDIO_GET_MAX_BASS_CONTROL:
            request->buffer = &g_UsbDeviceAudioSpeaker.maxBass;
            request->length = sizeof(g_UsbDeviceAudioSpeaker.maxBass);
            break;
        case USB_DEVICE_AUDIO_GET_MAX_MID_CONTROL:
            request->buffer = &g_UsbDeviceAudioSpeaker.maxMid;
            request->length = sizeof(g_UsbDeviceAudioSpeaker.maxMid);
            break;
        case USB_DEVICE_AUDIO_GET_MAX_TREBLE_CONTROL:
            request->buffer = &g_UsbDeviceAudioSpeaker.maxTreble;
            request->length = sizeof(g_UsbDeviceAudioSpeaker.maxTreble);
            break;
        case USB_DEVICE_AUDIO_GET_MAX_DELAY_CONTROL:
            request->buffer = g_UsbDeviceAudioSpeaker.maxDelay;
            request->length = sizeof(g_UsbDeviceAudioSpeaker.maxDelay);
            break;
        case USB_DEVICE_AUDIO_GET_MAX_SAMPLING_FREQ_CONTROL:
            request->buffer = g_UsbDeviceAudioSpeaker.maxSamplingFrequency;
            request->length = sizeof(g_UsbDeviceAudioSpeaker.maxSamplingFrequency);
            break;
        case USB_DEVICE_AUDIO_GET_RES_VOLUME_CONTROL:
            request->buffer = g_UsbDeviceAudioSpeaker.resVolume;
            request->length = sizeof(g_UsbDeviceAudioSpeaker.resVolume);
            break;
        case USB_DEVICE_AUDIO_GET_RES_BASS_CONTROL:
            request->buffer = &g_UsbDeviceAudioSpeaker.resBass;
            request->length = sizeof(g_UsbDeviceAudioSpeaker.resBass);
            break;
        case USB_DEVICE_AUDIO_GET_RES_MID_CONTROL:
            request->buffer = &g_UsbDeviceAudioSpeaker.resMid;
            request->length = sizeof(g_UsbDeviceAudioSpeaker.resMid);
            break;
        case USB_DEVICE_AUDIO_GET_RES_TREBLE_CONTROL:
            request->buffer = &g_UsbDeviceAudioSpeaker.resTreble;
            request->length = sizeof(g_UsbDeviceAudioSpeaker.resTreble);
            break;
        case USB_DEVICE_AUDIO_GET_RES_DELAY_CONTROL:
            request->buffer = g_UsbDeviceAudioSpeaker.resDelay;
            request->length = sizeof(g_UsbDeviceAudioSpeaker.resDelay);
            break;
        case USB_DEVICE_AUDIO_GET_RES_SAMPLING_FREQ_CONTROL:
            request->buffer = g_UsbDeviceAudioSpeaker.resSamplingFrequency;
            request->length = sizeof(g_UsbDeviceAudioSpeaker.resSamplingFrequency);
            break;
#if USBCFG_AUDIO_CLASS_2_0
        case USB_DEVICE_AUDIO_GET_CUR_SAM_FREQ_CONTROL:
            request->buffer = (uint8_t *)&g_UsbDeviceAudioSpeaker.curSampleFrequency;
            request->length = sizeof(g_UsbDeviceAudioSpeaker.curSampleFrequency);
            break;
        case USB_DEVICE_AUDIO_GET_RANGE_SAM_FREQ_CONTROL:
            request->buffer = (uint8_t *)&g_UsbDeviceAudioSpeaker.freqControlRange;
            request->length = sizeof(g_UsbDeviceAudioSpeaker.freqControlRange);
            break;
        case USB_DEVICE_AUDIO_GET_CUR_CLOCK_VALID_CONTROL:
            request->buffer = &g_UsbDeviceAudioSpeaker.curClockValid;
            request->length = sizeof(g_UsbDeviceAudioSpeaker.curClockValid);
            break;
        case USB_DEVICE_AUDIO_GET_CUR_MUTE_CONTROL_AUDIO20:
            request->buffer = (uint8_t *)&g_UsbDeviceAudioSpeaker.curMute20;
            request->length = sizeof(g_UsbDeviceAudioSpeaker.curMute20);
            break;
        case USB_DEVICE_AUDIO_GET_CUR_VOLUME_CONTROL_AUDIO20:
            request->buffer = (uint8_t *)&g_UsbDeviceAudioSpeaker.curVolume20;
            request->length = sizeof(g_UsbDeviceAudioSpeaker.curVolume20);
            break;
        case USB_DEVICE_AUDIO_GET_RANGE_VOLUME_CONTROL_AUDIO20:
            request->buffer = (uint8_t *)&g_UsbDeviceAudioSpeaker.volumeControlRange;
            request->length = sizeof(g_UsbDeviceAudioSpeaker.volumeControlRange);
            break;
#endif

        case USB_DEVICE_AUDIO_SET_CUR_VOLUME_CONTROL:
            if (request->isSetup == 1U)
            {
                request->buffer = g_UsbDeviceAudioSpeaker.curVolume;
            }
            else
            {
                uint16_t volume = (uint16_t)((uint16_t)g_UsbDeviceAudioSpeaker.curVolume[1] << 8U);
                volume |= (uint8_t)(g_UsbDeviceAudioSpeaker.curVolume[0]);
                g_UsbDeviceAudioSpeaker.codecTask |= VOLUME_CHANGE_TASK;
            }
            break;
        case USB_DEVICE_AUDIO_SET_CUR_MUTE_CONTROL:
            if (request->isSetup == 1U)
            {
                request->buffer = &g_UsbDeviceAudioSpeaker.curMute;
            }
            else
            {
                if (g_UsbDeviceAudioSpeaker.curMute)
                {
                    g_UsbDeviceAudioSpeaker.codecTask |= MUTE_CODEC_TASK;
                }
                else
                {
                    g_UsbDeviceAudioSpeaker.codecTask |= UNMUTE_CODEC_TASK;
                }
            }
            break;
        case USB_DEVICE_AUDIO_SET_CUR_BASS_CONTROL:
            if (request->isSetup == 1U)
            {
                request->buffer = &g_UsbDeviceAudioSpeaker.curBass;
            }
            break;
        case USB_DEVICE_AUDIO_SET_CUR_MID_CONTROL:
            if (request->isSetup == 1U)
            {
                request->buffer = &g_UsbDeviceAudioSpeaker.curMid;
            }
            break;
        case USB_DEVICE_AUDIO_SET_CUR_TREBLE_CONTROL:
            if (request->isSetup == 1U)
            {
                request->buffer = &g_UsbDeviceAudioSpeaker.curTreble;
            }
            break;
        case USB_DEVICE_AUDIO_SET_CUR_AUTOMATIC_GAIN_CONTROL:
            if (request->isSetup == 1U)
            {
                request->buffer = &g_UsbDeviceAudioSpeaker.curAutomaticGain;
            }
            break;
        case USB_DEVICE_AUDIO_SET_CUR_DELAY_CONTROL:
            if (request->isSetup == 1U)
            {
                request->buffer = g_UsbDeviceAudioSpeaker.curDelay;
            }
            break;
        case USB_DEVICE_AUDIO_SET_CUR_SAMPLING_FREQ_CONTROL:
            if (request->isSetup == 1U)
            {
                request->buffer = g_UsbDeviceAudioSpeaker.curSamplingFrequency;
            }
            break;
        case USB_DEVICE_AUDIO_SET_MIN_VOLUME_CONTROL:
            if (request->isSetup == 1U)
            {
                request->buffer = g_UsbDeviceAudioSpeaker.minVolume;
            }
            break;
        case USB_DEVICE_AUDIO_SET_MIN_BASS_CONTROL:
            if (request->isSetup == 1U)
            {
                request->buffer = &g_UsbDeviceAudioSpeaker.minBass;
            }
            break;
        case USB_DEVICE_AUDIO_SET_MIN_MID_CONTROL:
            if (request->isSetup == 1U)
            {
                request->buffer = &g_UsbDeviceAudioSpeaker.minMid;
            }
            break;
        case USB_DEVICE_AUDIO_SET_MIN_TREBLE_CONTROL:
            if (request->isSetup == 1U)
            {
                request->buffer = &g_UsbDeviceAudioSpeaker.minTreble;
            }
            break;
        case USB_DEVICE_AUDIO_SET_MIN_DELAY_CONTROL:
            if (request->isSetup == 1U)
            {
                request->buffer = g_UsbDeviceAudioSpeaker.minDelay;
            }
            break;
        case USB_DEVICE_AUDIO_SET_MIN_SAMPLING_FREQ_CONTROL:
            if (request->isSetup == 1U)
            {
                request->buffer = g_UsbDeviceAudioSpeaker.minSamplingFrequency;
            }
            break;
        case USB_DEVICE_AUDIO_SET_MAX_VOLUME_CONTROL:
            if (request->isSetup == 1U)
            {
                request->buffer = g_UsbDeviceAudioSpeaker.maxVolume;
            }
            break;
        case USB_DEVICE_AUDIO_SET_MAX_BASS_CONTROL:
            if (request->isSetup == 1U)
            {
                request->buffer = &g_UsbDeviceAudioSpeaker.maxBass;
            }
            break;
        case USB_DEVICE_AUDIO_SET_MAX_MID_CONTROL:
            if (request->isSetup == 1U)
            {
                request->buffer = &g_UsbDeviceAudioSpeaker.maxMid;
            }
            break;
        case USB_DEVICE_AUDIO_SET_MAX_TREBLE_CONTROL:
            if (request->isSetup == 1U)
            {
                request->buffer = &g_UsbDeviceAudioSpeaker.maxTreble;
            }
            break;
        case USB_DEVICE_AUDIO_SET_MAX_DELAY_CONTROL:
            if (request->isSetup == 1U)
            {
                request->buffer = g_UsbDeviceAudioSpeaker.maxDelay;
            }
            break;
        case USB_DEVICE_AUDIO_SET_MAX_SAMPLING_FREQ_CONTROL:
            if (request->isSetup == 1U)
            {
                request->buffer = g_UsbDeviceAudioSpeaker.maxSamplingFrequency;
            }
            break;
        case USB_DEVICE_AUDIO_SET_RES_VOLUME_CONTROL:
            if (request->isSetup == 1U)
            {
                request->buffer = g_UsbDeviceAudioSpeaker.resVolume;
            }
            break;
        case USB_DEVICE_AUDIO_SET_RES_BASS_CONTROL:
            if (request->isSetup == 1U)
            {
                request->buffer = &g_UsbDeviceAudioSpeaker.resBass;
            }
            break;
        case USB_DEVICE_AUDIO_SET_RES_MID_CONTROL:
            if (request->isSetup == 1U)
            {
                request->buffer = &g_UsbDeviceAudioSpeaker.resMid;
            }
            break;
        case USB_DEVICE_AUDIO_SET_RES_TREBLE_CONTROL:
            if (request->isSetup == 1U)
            {
                request->buffer = &g_UsbDeviceAudioSpeaker.resTreble;
            }
            break;
        case USB_DEVICE_AUDIO_SET_RES_DELAY_CONTROL:
            if (request->isSetup == 1U)
            {
                request->buffer = g_UsbDeviceAudioSpeaker.resDelay;
            }
            break;
        case USB_DEVICE_AUDIO_SET_RES_SAMPLING_FREQ_CONTROL:
            if (request->isSetup == 1U)
            {
                request->buffer = g_UsbDeviceAudioSpeaker.resSamplingFrequency;
            }
            break;
#if USBCFG_AUDIO_CLASS_2_0
        case USB_DEVICE_AUDIO_SET_CUR_SAM_FREQ_CONTROL:
            if (request->isSetup == 1U)
            {
                request->buffer = (uint8_t *)&g_UsbDeviceAudioSpeaker.curSampleFrequency;
            }
            break;
        case USB_DEVICE_AUDIO_SET_CUR_CLOCK_VALID_CONTROL:
            if (request->isSetup == 1U)
            {
                request->buffer = &g_UsbDeviceAudioSpeaker.curClockValid;
            }
            break;
        case USB_DEVICE_AUDIO_SET_CUR_MUTE_CONTROL_AUDIO20:
            if (request->isSetup == 1U)
            {
                request->buffer = &g_UsbDeviceAudioSpeaker.curMute20;
            }
            else
            {
                if (g_UsbDeviceAudioSpeaker.curMute20)
                {
                    g_UsbDeviceAudioSpeaker.codecTask |= MUTE_CODEC_TASK;
                }
                else
                {
                    g_UsbDeviceAudioSpeaker.codecTask |= UNMUTE_CODEC_TASK;
                }
            }
            break;
        case USB_DEVICE_AUDIO_SET_CUR_VOLUME_CONTROL_AUDIO20:
            if (request->isSetup == 1U)
            {
                request->buffer = g_UsbDeviceAudioSpeaker.curVolume20;
            }
            else
            {
                g_UsbDeviceAudioSpeaker.codecTask |= VOLUME_CHANGE_TASK;
            }
            break;
#endif
        default:
            error = kStatus_USB_InvalidRequest;
            break;
    }
    return error;
}

/* The USB_AudioSpeakerBufferSpaceUsed() function gets the used speaker ringbuffer size */
uint32_t USB_AudioSpeakerBufferSpaceUsed(void)
{
    if (g_UsbDeviceAudioSpeaker.tdReadNumberPlay > g_UsbDeviceAudioSpeaker.tdWriteNumberPlay)
    {
        g_UsbDeviceAudioSpeaker.speakerReservedSpace =
            g_UsbDeviceAudioSpeaker.tdReadNumberPlay - g_UsbDeviceAudioSpeaker.tdWriteNumberPlay;
    }
    else
    {
        g_UsbDeviceAudioSpeaker.speakerReservedSpace =
            g_UsbDeviceAudioSpeaker.tdReadNumberPlay +
            AUDIO_SPEAKER_DATA_WHOLE_BUFFER_LENGTH * FS_ISO_OUT_ENDP_PACKET_SIZE -
            g_UsbDeviceAudioSpeaker.tdWriteNumberPlay;
    }
    return g_UsbDeviceAudioSpeaker.speakerReservedSpace;
}

#if defined(USB_DEVICE_AUDIO_USE_SYNC_MODE) && (USB_DEVICE_AUDIO_USE_SYNC_MODE > 0U)
#else
/* The USB_AudioFeedbackDataUpdate() function calculates the feedback data */
void USB_AudioFeedbackDataUpdate()
{
    static int32_t audioSpeakerUsedDiff = 0x0, audioSpeakerDiffThres = 0x0;
    static uint32_t feedbackValue = 0x0, originFeedbackValue = 0x0, audioSpeakerUsedSpace = 0x0,
                    audioSpeakerLastUsedSpace = 0x0;

    if (g_UsbDeviceAudioSpeaker.speakerIntervalCount != AUDIO_CALCULATE_Ff_INTERVAL)
    {
        g_UsbDeviceAudioSpeaker.speakerIntervalCount++;
        return;
    }
    g_UsbDeviceAudioSpeaker.speakerIntervalCount = 1;
    g_UsbDeviceAudioSpeaker.timesFeedbackCalculate++;
    if (g_UsbDeviceAudioSpeaker.timesFeedbackCalculate == 2)
    {
        originFeedbackValue = ((g_UsbDeviceAudioSpeaker.audioSendCount - g_UsbDeviceAudioSpeaker.lastAudioSendCount)) /
                              (AUDIO_FORMAT_CHANNELS * AUDIO_FORMAT_SIZE);
        feedbackValue = originFeedbackValue;
        AUDIO_UPDATE_FEEDBACK_DATA(audioFeedBackBuffer, originFeedbackValue);
        audioSpeakerUsedSpace     = USB_AudioSpeakerBufferSpaceUsed();
        audioSpeakerLastUsedSpace = audioSpeakerUsedSpace;
    }
    else if (g_UsbDeviceAudioSpeaker.timesFeedbackCalculate > 2)
    {
        audioSpeakerUsedSpace = USB_AudioSpeakerBufferSpaceUsed();
        audioSpeakerUsedDiff += (audioSpeakerUsedSpace - audioSpeakerLastUsedSpace);
        audioSpeakerLastUsedSpace = audioSpeakerUsedSpace;

        if ((audioSpeakerUsedDiff > -AUDIO_SAMPLING_RATE_KHZ) && (audioSpeakerUsedDiff < AUDIO_SAMPLING_RATE_KHZ))
        {
            audioSpeakerDiffThres = 4 * AUDIO_SAMPLING_RATE_KHZ;
        }
        if (audioSpeakerUsedDiff <= -audioSpeakerDiffThres)
        {
            audioSpeakerDiffThres += 4 * AUDIO_SAMPLING_RATE_KHZ;
            feedbackValue += (AUDIO_SAMPLING_RATE_KHZ / AUDIO_SAMPLING_RATE_16KHZ) * (AUDIO_ADJUST_MIN_STEP);
        }
        if (audioSpeakerUsedDiff >= audioSpeakerDiffThres)
        {
            audioSpeakerDiffThres += 4 * AUDIO_SAMPLING_RATE_KHZ;
            feedbackValue -= (AUDIO_SAMPLING_RATE_KHZ / AUDIO_SAMPLING_RATE_16KHZ) * (AUDIO_ADJUST_MIN_STEP);
        }
        AUDIO_UPDATE_FEEDBACK_DATA(audioFeedBackBuffer, feedbackValue);
    }
    else
    {
    }
    g_UsbDeviceAudioSpeaker.lastAudioSendCount = g_UsbDeviceAudioSpeaker.audioSendCount;
}
#endif

/* The USB_AudioSpeakerPutBuffer() function fills the audioRecDataBuff with audioPlayPacket in every callback*/
void USB_AudioSpeakerPutBuffer(uint8_t *buffer, uint32_t size)
{
    while (size)
    {
        audioPlayDataBuff[g_UsbDeviceAudioSpeaker.tdReadNumberPlay] = *buffer;
        g_UsbDeviceAudioSpeaker.tdReadNumberPlay++;
        buffer++;
        size--;

        if (g_UsbDeviceAudioSpeaker.tdReadNumberPlay >=
            AUDIO_SPEAKER_DATA_WHOLE_BUFFER_LENGTH * FS_ISO_OUT_ENDP_PACKET_SIZE)
        {
            g_UsbDeviceAudioSpeaker.tdReadNumberPlay = 0;
        }
    }
}
/*!
 * @brief Audio class specific callback function.
 *
 * This function handles the Audio class specific requests.
 *
 * @param handle		  The Audio class handle.
 * @param event 		  The Audio class event type.
 * @param param 		  The parameter of the class specific request.
 *
 * @return A USB error code or kStatus_USB_Success.
 */
usb_status_t USB_DeviceAudioCallback(class_handle_t handle, uint32_t event, void *param)
{
    usb_status_t error = kStatus_USB_Error;
    usb_device_endpoint_callback_message_struct_t *ep_cb_param;
    ep_cb_param = (usb_device_endpoint_callback_message_struct_t *)param;

    switch (event)
    {
#if defined(USB_DEVICE_AUDIO_USE_SYNC_MODE) && (USB_DEVICE_AUDIO_USE_SYNC_MODE > 0U)
#else
        case kUSB_DeviceAudioEventStreamSendResponse:
            if ((g_UsbDeviceAudioSpeaker.attach) && (ep_cb_param->length != (USB_UNINITIALIZED_VAL_32)))
            {
                if (ep_cb_param->length == g_UsbDeviceAudioSpeaker.currentFeedbackMaxPacketSize)
                {
                    error = USB_DeviceAudioSend(handle, USB_AUDIO_SPEAKER_FEEDBACK_ENDPOINT, audioFeedBackBuffer,
                                                g_UsbDeviceAudioSpeaker.currentFeedbackMaxPacketSize);
                }
            }
            break;
#endif
        case kUSB_DeviceAudioEventStreamRecvResponse:
            if ((g_UsbDeviceAudioSpeaker.attach) && (ep_cb_param->length != (USB_UNINITIALIZED_VAL_32)))
            {
                if (g_UsbDeviceAudioSpeaker.startPlay == 0)
                {
                    g_UsbDeviceAudioSpeaker.startPlay = 1;
                }
                if ((g_UsbDeviceAudioSpeaker.tdReadNumberPlay >=
                     AUDIO_SPEAKER_DATA_WHOLE_BUFFER_LENGTH * FS_ISO_OUT_ENDP_PACKET_SIZE / 2) &&
                    (g_UsbDeviceAudioSpeaker.startPlayHalfFull == 0))
                {
                    g_UsbDeviceAudioSpeaker.startPlayHalfFull = 1;
                }
                USB_AudioSpeakerPutBuffer(audioPlayPacket, ep_cb_param->length);
                g_UsbDeviceAudioSpeaker.usbRecvCount += ep_cb_param->length;
                g_UsbDeviceAudioSpeaker.usbRecvTimes++;
#if defined(USB_DEVICE_AUDIO_USE_SYNC_MODE) && (USB_DEVICE_AUDIO_USE_SYNC_MODE > 0U)
                error = USB_DeviceAudioRecv(handle, USB_AUDIO_SPEAKER_STREAM_ENDPOINT, &audioPlayPacket[0],
                                            (FS_ISO_OUT_ENDP_PACKET_SIZE));
#else
                USB_AUDIO_ENTER_CRITICAL();
                USB_AudioFeedbackDataUpdate();
                USB_AUDIO_EXIT_CRITICAL();
                error = USB_DeviceAudioRecv(handle, USB_AUDIO_SPEAKER_STREAM_ENDPOINT, &audioPlayPacket[0],
                                            g_UsbDeviceAudioSpeaker.currentStreamOutMaxPacketSize);
#endif
            }
            break;

        default:
            if (param && (event > 0xFF))
            {
                error = USB_DeviceAudioRequest(handle, event, param);
            }
            break;
    }

    return error;
}

/* The USB_DeviceAudioSpeakerStatusReset() function resets the audio speaker status to the initialized status */
void USB_DeviceAudioSpeakerStatusReset(void)
{
    g_UsbDeviceAudioSpeaker.startPlay              = 0;
    g_UsbDeviceAudioSpeaker.startPlayHalfFull      = 0;
    g_UsbDeviceAudioSpeaker.tdReadNumberPlay       = 0;
    g_UsbDeviceAudioSpeaker.tdWriteNumberPlay      = 0;
    g_UsbDeviceAudioSpeaker.audioSendCount         = 0;
    g_UsbDeviceAudioSpeaker.usbRecvCount           = 0;
    g_UsbDeviceAudioSpeaker.lastAudioSendCount     = 0;
    g_UsbDeviceAudioSpeaker.audioSendTimes         = 0;
    g_UsbDeviceAudioSpeaker.usbRecvTimes           = 0;
    g_UsbDeviceAudioSpeaker.speakerIntervalCount   = 0;
    g_UsbDeviceAudioSpeaker.speakerReservedSpace   = 0;
    g_UsbDeviceAudioSpeaker.timesFeedbackCalculate = 0;
    g_UsbDeviceAudioSpeaker.speakerDetachOrNoInput = 0;
#if defined(USB_DEVICE_AUDIO_USE_SYNC_MODE) && (USB_DEVICE_AUDIO_USE_SYNC_MODE > 0U)
    g_UsbDeviceAudioSpeaker.audioPllTicksPrev   = 0;
    g_UsbDeviceAudioSpeaker.audioPllTicksDiff   = 0;
    g_UsbDeviceAudioSpeaker.audioPllTicksEma    = AUDIO_PLL_USB1_SOF_INTERVAL_COUNT;
    g_UsbDeviceAudioSpeaker.audioPllTickEmaFrac = 0;
    g_UsbDeviceAudioSpeaker.audioPllStep        = AUDIO_PLL_FRACTIONAL_CHANGE_STEP;
#endif
}

/*!
 * @brief USB device callback function.
 *
 * This function handles the usb device specific requests.
 *
 * @param handle		  The USB device handle.
 * @param event 		  The USB device event type.
 * @param param 		  The parameter of the device specific request.
 *
 * @return A USB error code or kStatus_USB_Success.
 */
usb_status_t USB_DeviceCallback(usb_device_handle handle, uint32_t event, void *param)
{
    usb_status_t error = kStatus_USB_Error;
    uint8_t *temp8     = (uint8_t *)param;
    uint16_t *temp16   = (uint16_t *)param;
    uint8_t count      = 0U;

    switch (event)
    {
        case kUSB_DeviceEventBusReset:
        {
            for (count = 0U; count < USB_AUDIO_SPEAKER_INTERFACE_COUNT; count++)
            {
                g_UsbDeviceAudioSpeaker.currentInterfaceAlternateSetting[count] = 0U;
            }
            g_UsbDeviceAudioSpeaker.attach               = 0U;
            g_UsbDeviceAudioSpeaker.currentConfiguration = 0U;
            error                                        = kStatus_USB_Success;
#if (defined(USB_DEVICE_CONFIG_EHCI) && (USB_DEVICE_CONFIG_EHCI > 0U)) || \
    (defined(USB_DEVICE_CONFIG_LPCIP3511HS) && (USB_DEVICE_CONFIG_LPCIP3511HS > 0U))
            /* Get USB speed to configure the device, including max packet size and interval of the endpoints. */
            if (kStatus_USB_Success == USB_DeviceClassGetSpeed(CONTROLLER_ID, &g_UsbDeviceAudioSpeaker.speed))
            {
                USB_DeviceSetSpeed(handle, g_UsbDeviceAudioSpeaker.speed);
            }
#if USBCFG_AUDIO_CLASS_2_0 
#if defined(USB_DEVICE_AUDIO_USE_SYNC_MODE) && (USB_DEVICE_AUDIO_USE_SYNC_MODE > 0U)
#else
            AUDIO_UPDATE_FEEDBACK_DATA(audioFeedBackBuffer, AUDIO_SAMPLING_RATE_TO_10_14);
#endif    
#endif        
            if (USB_SPEED_HIGH == g_UsbDeviceAudioSpeaker.speed)
            {
#if defined(USB_DEVICE_AUDIO_USE_SYNC_MODE) && (USB_DEVICE_AUDIO_USE_SYNC_MODE > 0U)
                g_UsbDeviceAudioSpeaker.currentStreamOutMaxPacketSize = (HS_ISO_OUT_ENDP_PACKET_SIZE);
#else
                g_UsbDeviceAudioSpeaker.currentStreamOutMaxPacketSize =
                    (HS_ISO_OUT_ENDP_PACKET_SIZE + AUDIO_FORMAT_CHANNELS * AUDIO_FORMAT_SIZE);
                g_UsbDeviceAudioSpeaker.currentFeedbackMaxPacketSize = HS_ISO_FEEDBACK_ENDP_PACKET_SIZE;
#endif
            }
            else
            {
#if defined(USB_DEVICE_AUDIO_USE_SYNC_MODE) && (USB_DEVICE_AUDIO_USE_SYNC_MODE > 0U)
#else
                g_UsbDeviceAudioSpeaker.currentFeedbackMaxPacketSize = FS_ISO_FEEDBACK_ENDP_PACKET_SIZE;
#endif
            }
#endif
        }
        break;
        case kUSB_DeviceEventSetConfiguration:
            if (0U == (*temp8))
            {
                g_UsbDeviceAudioSpeaker.attach               = 0U;
                g_UsbDeviceAudioSpeaker.currentConfiguration = 0U;
            }
            else if (USB_AUDIO_SPEAKER_CONFIGURE_INDEX == (*temp8))
            {
                g_UsbDeviceAudioSpeaker.attach               = 1U;
                g_UsbDeviceAudioSpeaker.currentConfiguration = *temp8;
            }
            else
            {
                error = kStatus_USB_InvalidRequest;
            }
            break;
        case kUSB_DeviceEventSetInterface:
            if (g_UsbDeviceAudioSpeaker.attach)
            {
                uint8_t interface        = (uint8_t)((*temp16 & 0xFF00U) >> 0x08U);
                uint8_t alternateSetting = (uint8_t)(*temp16 & 0x00FFU);

                if (g_UsbDeviceAudioSpeaker.currentInterfaceAlternateSetting[interface] != alternateSetting)
                {
                    g_UsbDeviceAudioSpeaker.currentInterfaceAlternateSetting[interface] = alternateSetting;
                    if (alternateSetting == 1U)
                    {
                        USB_DeviceAudioSpeakerStatusReset();
                        USB_DeviceAudioRecv(g_UsbDeviceAudioSpeaker.audioHandle, USB_AUDIO_SPEAKER_STREAM_ENDPOINT,
                                            &audioPlayDataBuff[0],
                                            g_UsbDeviceAudioSpeaker.currentStreamOutMaxPacketSize);
#if defined(USB_DEVICE_AUDIO_USE_SYNC_MODE) && (USB_DEVICE_AUDIO_USE_SYNC_MODE > 0U)
#else
                        USB_DeviceAudioSend(g_UsbDeviceAudioSpeaker.audioHandle, USB_AUDIO_SPEAKER_FEEDBACK_ENDPOINT,
                                            audioFeedBackBuffer, g_UsbDeviceAudioSpeaker.currentFeedbackMaxPacketSize);
#endif
                    }
                }
            }
            break;
        case kUSB_DeviceEventGetConfiguration:
            if (param)
            {
                *temp8 = g_UsbDeviceAudioSpeaker.currentConfiguration;
                error  = kStatus_USB_Success;
            }
            break;
        case kUSB_DeviceEventGetInterface:
            if (param)
            {
                /* Get current alternate setting of the interface request */
                uint8_t interface = (uint8_t)((*temp16 & 0xFF00U) >> 0x08U);
                if (interface < USB_AUDIO_SPEAKER_INTERFACE_COUNT)
                {
                    *temp16 = (*temp16 & 0xFF00U) | g_UsbDeviceAudioSpeaker.currentInterfaceAlternateSetting[interface];
                    error   = kStatus_USB_Success;
                }
                else
                {
                    error = kStatus_USB_InvalidRequest;
                }
            }
            break;
        case kUSB_DeviceEventGetDeviceDescriptor:
            if (param)
            {
                /* Get device descriptor request */
                error = USB_DeviceGetDeviceDescriptor(handle, (usb_device_get_device_descriptor_struct_t *)param);
            }
            break;
        case kUSB_DeviceEventGetConfigurationDescriptor:
            if (param)
            {
                /* Get device configuration descriptor request */
                error = USB_DeviceGetConfigurationDescriptor(handle,
                                                             (usb_device_get_configuration_descriptor_struct_t *)param);
            }
            break;
        case kUSB_DeviceEventGetStringDescriptor:
            if (param)
            {
                /* Get device string descriptor request */
                error = USB_DeviceGetStringDescriptor(handle, (usb_device_get_string_descriptor_struct_t *)param);
            }
            break;
        default:
            break;
    }

    return error;
}

/*!
 * @brief Application initialization function.
 *
 * This function initializes the application.
 *
 * @return None.
 */

void APPInit(void)
{
    USB_DeviceClockInit();
#if (defined(FSL_FEATURE_SOC_SYSMPU_COUNT) && (FSL_FEATURE_SOC_SYSMPU_COUNT > 0U))
    SYSMPU_Enable(SYSMPU, 0);
#endif /* FSL_FEATURE_SOC_SYSMPU_COUNT */
    Init_Board_Audio();
#if defined(USB_DEVICE_AUDIO_USE_SYNC_MODE) && (USB_DEVICE_AUDIO_USE_SYNC_MODE > 0U)
    SCTIMER_CaptureInit();
#else
    AUDIO_UPDATE_FEEDBACK_DATA(audioFeedBackBuffer, AUDIO_SAMPLING_RATE_TO_10_14);
#endif

    if (kStatus_USB_Success !=
        USB_DeviceClassInit(CONTROLLER_ID, &s_audioConfigList, &g_UsbDeviceAudioSpeaker.deviceHandle))
    {
        usb_echo("USB device failed\r\n");
        return;
    }
    else
    {
        usb_echo("USB device audio speaker demo\r\n");
        g_UsbDeviceAudioSpeaker.audioHandle = s_audioConfigList.config->classHandle;
    }

    /* Install isr, set priority, and enable IRQ. */
    USB_DeviceIsrEnable();

    USB_DeviceRun(g_UsbDeviceAudioSpeaker.deviceHandle);
}

void USB_AudioCodecTask(void)
{
    if (g_UsbDeviceAudioSpeaker.codecTask & MUTE_CODEC_TASK)
    {
#if USBCFG_AUDIO_CLASS_2_0
        usb_echo("Set Cur Mute : %x\r\n", g_UsbDeviceAudioSpeaker.curMute20);
#else
        usb_echo("Set Cur Mute : %x\r\n", g_UsbDeviceAudioSpeaker.curMute);
#endif
        g_UsbDeviceAudioSpeaker.codecTask &= ~MUTE_CODEC_TASK;
    }
    if (g_UsbDeviceAudioSpeaker.codecTask & UNMUTE_CODEC_TASK)
    {
#if USBCFG_AUDIO_CLASS_2_0
        usb_echo("Set Cur Mute : %x\r\n", g_UsbDeviceAudioSpeaker.curMute20);
#else
        usb_echo("Set Cur Mute : %x\r\n", g_UsbDeviceAudioSpeaker.curMute);
#endif
        g_UsbDeviceAudioSpeaker.codecTask &= ~UNMUTE_CODEC_TASK;
    }
    if (g_UsbDeviceAudioSpeaker.codecTask & VOLUME_CHANGE_TASK)
    {
#if USBCFG_AUDIO_CLASS_2_0
        usb_echo("Set Cur Volume : %x\r\n",
                 (uint16_t)(g_UsbDeviceAudioSpeaker.curVolume20[1] << 8U) | g_UsbDeviceAudioSpeaker.curVolume20[0]);
#else
        usb_echo("Set Cur Volume : %x\r\n",
                 (uint16_t)(g_UsbDeviceAudioSpeaker.curVolume[1] << 8U) | g_UsbDeviceAudioSpeaker.curVolume[0]);
        CS43130_SetVolume(g_UsbDeviceAudioSpeaker.curVolume[0]);
#endif
        g_UsbDeviceAudioSpeaker.codecTask &= ~VOLUME_CHANGE_TASK;
    }
}

void USB_AudioSpeakerResetTask(void)
{
    if (g_UsbDeviceAudioSpeaker.speakerDetachOrNoInput)
    {
        USB_DeviceAudioSpeakerStatusReset();
    }
}
/*!
 * @brief Application task function.
 *
 * This function runs the task for application.
 *
 * @return None.
 */
int USB_AudioSpeakerInit(void)
{
    /* Set shared signal set 0: SCK, WS from Flexcomm1 */
    SYSCTL->SHAREDCTRLSET[0] |= 0X77;
    ;
    /* Set flexcomm3 SCK, WS from shared signal set 0 */
    SYSCTL->FCCTRLSEL[6] |= 0X101;

    NVIC_ClearPendingIRQ(USB0_IRQn);
    NVIC_ClearPendingIRQ(USB0_NEEDCLK_IRQn);
    NVIC_ClearPendingIRQ(USB1_IRQn);
    NVIC_ClearPendingIRQ(USB1_NEEDCLK_IRQn);

    POWER_DisablePD(kPDRUNCFG_PD_USB0_PHY); /*< Turn on USB0 Phy */
    POWER_DisablePD(kPDRUNCFG_PD_USB1_PHY); /*< Turn on USB1 Phy */

    /* reset the IP to make sure it's in reset state. */
    RESET_PeripheralReset(kUSB0D_RST_SHIFT_RSTn);
    RESET_PeripheralReset(kUSB0HSL_RST_SHIFT_RSTn);
    RESET_PeripheralReset(kUSB0HMR_RST_SHIFT_RSTn);
    RESET_PeripheralReset(kUSB1H_RST_SHIFT_RSTn);
    RESET_PeripheralReset(kUSB1D_RST_SHIFT_RSTn);
    RESET_PeripheralReset(kUSB1_RST_SHIFT_RSTn);
    RESET_PeripheralReset(kUSB1RAM_RST_SHIFT_RSTn);

#if (defined USB_DEVICE_CONFIG_LPCIP3511HS) && (USB_DEVICE_CONFIG_LPCIP3511HS)
    CLOCK_EnableClock(kCLOCK_Usbh1);
    /* Put PHY powerdown under software control */
    *((uint32_t *)(USBHSH_BASE + 0x50)) = USBHSH_PORTMODE_SW_PDCOM_MASK;
    /* According to reference mannual, device mode setting has to be set by access usb host register */
    *((uint32_t *)(USBHSH_BASE + 0x50)) |= USBHSH_PORTMODE_DEV_ENABLE_MASK;
    /* enable usb1 host clock */
    CLOCK_DisableClock(kCLOCK_Usbh1);
#endif
#if (defined USB_DEVICE_CONFIG_LPCIP3511FS) && (USB_DEVICE_CONFIG_LPCIP3511FS)
    POWER_DisablePD(kPDRUNCFG_PD_USB0_PHY); /*< Turn on USB Phy */
    CLOCK_SetClkDiv(kCLOCK_DivUsb0Clk, 1, false);
    CLOCK_AttachClk(kFRO_HF_to_USB0_CLK);
    /* enable usb0 host clock */
    CLOCK_EnableClock(kCLOCK_Usbhsl0);
    /*According to reference mannual, device mode setting has to be set by access usb host register */
    *((uint32_t *)(USBFSH_BASE + 0x5C)) |= USBFSH_PORTMODE_DEV_ENABLE_MASK;
    /* disable usb0 host clock */
    CLOCK_DisableClock(kCLOCK_Usbhsl0);
#endif

    APPInit();
}

void USB_AudioSpeakerLoop() {
	USB_AudioCodecTask();

	USB_AudioSpeakerResetTask();

#if USB_DEVICE_CONFIG_USE_TASK
	USB_DeviceTaskFn(g_UsbDeviceAudioSpeaker.deviceHandle);
#endif
}
