zephray/Bric/bringup/source/epd.c

//
// Project Bric
// Copyright 2020 Wenting Zhang
//
// This Source Code Form is subject to the terms of the Mozilla Public
// License, v. 2.0. If a copy of the MPL was not distributed with this
// file, You can obtain one at https://mozilla.org/MPL/2.0/.
//
// This file is partially derived from waveshare e-paper EPD driver
#include "fsl_common.h"
#include "fsl_spi.h"
#include "fsl_gpio.h"
#include "pin_mux.h"
#include "epd.h"

#define EPD_SPI SPI3

const unsigned char gImage_8bpp[30500] = { /* 0X00,0X08,0XFA,0X00,0X7A,0X00, */
0X00,0X00,0X00,0X00,0X00,0X00,0X00,0X00,0X00,0X00,0X00,0X00,0X00,0X00,0X00,0X00,
0X00,0X00,0X00,0X00,0X00,0X00,0X00,0X00,0X00,0X00,0X00,0X00,0X00,0X00,0X00,0X00,
0X00,0X00,0X00,0X00,0X00,0X00,0X00,0X00,0X00,0X00,0X00,0X00,0X00,0X00,0X00,0X00,
0X00,0X00,0X00,0X00,0X00,0X00,0X00,0X00,0X00,0X00,0X00,0X00,0X00,0X00,0X00,0X00,
0X00,0X00,0X00,0X00,0X00,0X00,0X00,0X00,0X00,0X00,0X00,0X00,0X00,0X00,0X00,0X00,
0X00,0X00,0X00,0X00,0X00,0X00,0X00,0X00,0X00,0X00,0X00,0X00,0X00,0X00,0X00,0X00,
0X00,0X00,0X00,0X00,0X00,0X00,0X00,0X00,0X00,0X00,0X00,0X00,0X00,0X00,0X00,0X00,
0X00,0X00,0X00,0X00,0X00,0X00,0X00,0X00,0X00,0X00,0X00,0X00,0X00,0X00,0X00,0X00,
0X00,0X00,0X00,0X00,0X00,0X00,0X00,0X00,0X00,0X00,0X00,0X00,0X00,0X00,0X00,0X00,
0X00,0X00,0X00,0X00,0X00,0X00,0X00,0X00,0X00,0X00,0X00,0X00,0X00,0X00,0X00,0X00,
0X00,0X00,0X00,0X00,0X00,0X00,0X00,0X00,0X00,0X00,0X00,0X00,0X00,0X00,0X00,0X00,
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
0X79,0X77,0X75,0X73,0X71,0X6F,0X6E,0X6C,0X6A,0X68,0X67,0X65,0X63,0X61,0X5F,0X5E,
0X5B,0X59,0X58,0X56,0X54,0X53,0X51,0X4F,0X4D,0X4C,0X4A,0X48,0X46,0X45,0X42,0X41,
0X3F,0X3E,0X3C,0X3A,0X39,0X37,0X36,0X34,0X32,0X31,0X2F,0X2E,0X2C,0X2B,0X29,0X28,
0X26,0X25,0X23,0X22,0X20,0X1F,0X1E,0X1D,0X1B,0X1A,0X18,0X17,0X16,0X15,0X14,0X12,
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
