zephray/Bric/firmware/app/decoder.h

//
// Project Bric
// Copyright 2020 Wenting Zhang
//
// This Source Code Form is subject to the terms of the Mozilla Public
// License, v. 2.0. If a copy of the MPL was not distributed with this
// file, You can obtain one at https://mozilla.org/MPL/2.0/.
//
#ifndef __DECODER_H__
#define __DECODER_H__

// The decoder subsystem owns two threads, one fetcher thread, one decoder
// thread. The fetcher thread pushes raw data read from SD card into the FIFO,
// the decoder decodes the audio and send the audio frame into audio DMA.
// The core of the audio subsystem is an FIFO: the producer (decoder) thread
// pushes decoded audio frame into the FIFO, the consumer (which is connect to 
// audio DMA) takes decoded audio frame from the FIFO.

// The producer will keeps pushing raw audio file into the FIFO until it reaches
// the definied size. Request to pushing more frames into the FIFO should be
// rejected.
#define QUEUE_OBJECT (8192)
// The fetcher hold one additional buffer and the decoder holds
#define QUEUE_LENGTH (1)

#define MAX_FRAME_SIZE (1152*2*2)

typedef enum {
    FMT_UNKNOWN,
    FMT_MP3,
    FMT_WAV
} FileFormat;

typedef struct {
    FileFormat fmt;
    // Decoder handle
    mp3dec_t mp3d;
    // Input file
    File * file;
    size_t file_size;
    uint32_t sample_rate;
    AudioFormat output_format;
    uint32_t bits_per_sample;
    // For communication between fetch and decode
    QueueHandle_t input_queue; // allocated dynamically
    // Input file counting
    size_t offset; // Current input file offset
    size_t processed; // Current processed byte count
    // File information
    uint32_t samples;
    uint32_t channels;
    // Playing status
    volatile bool playing;
    volatile bool finished;
    // Threads
    TaskHandle_t fetch_handle;
    TaskHandle_t decode_handle;
} DecoderContext;

int dec_openfile(DecoderContext *ctx, char *fname, FileFormat fmt);
void dec_decode(DecoderContext *ctx, uint8_t *buf, int bytes);
size_t dec_audio_callback(void *userdata, uint8_t *stream, uint32_t len);
int dec_play(DecoderContext *ctx);
int dec_pause(DecoderContext *ctx);
int dec_close(DecoderContext *ctx);

#endif
