zephray/Bric/firmware/mcu/source/hal_input.c

//
// Project Fobu
// Copyright 2020 Wenting Zhang
//
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
// File : os_input.c
// Brief: Keypad input OS Abstraction Layer
//
#include "FreeRTOS.h"
#include "task.h"
#include "queue.h"
#include "timers.h"
#include "semphr.h"
#include <stdio.h>
#include <stdbool.h>
#include "fsl_gpio.h"
#include "pin_mux.h"
#include "hal_input.h"

static uint32_t key_state;

void hal_input_init(void) {
    key_state = 0;
}

uint32_t hal_input_get_keys(void) {
    return key_state;
}

static uint32_t hal_input_get_keys_raw(void) {
    uint32_t key_state = 0;
    key_state |= (!GPIO_PinRead(GPIO, BOARD_INITPINS_SW_SEL_PORT,
            BOARD_INITPINS_SW_SEL_PIN)) << KEY_SHIFT_YES;
    key_state |= (!GPIO_PinRead(GPIO, BOARD_INITPINS_SW_PLUS_PORT,
            BOARD_INITPINS_SW_PLUS_PIN)) << KEY_SHIFT_UP;
    key_state |= (!GPIO_PinRead(GPIO, BOARD_INITPINS_SW_MIN_PORT,
            BOARD_INITPINS_SW_MIN_PIN)) << KEY_SHIFT_DOWN;
    key_state |= (!GPIO_PinRead(GPIO, BOARD_INITPINS_SW_BACK_PORT,
            BOARD_INITPINS_SW_BACK_PIN)) << KEY_SHIFT_NO;
    return key_state;
}

// Function to be called in background task
void hal_input_scan(void) {
    uint32_t state_1, state_2;
    state_1 = hal_input_get_keys_raw();
    if (state_1 ^ key_state) {
        // If the state is different
        // Debouncing
        vTaskDelay(pdMS_TO_TICKS(20));
        state_2 = hal_input_get_keys_raw();
        key_state = state_1 & state_2;
    }
}
