zephray/Bric/firmware/app/id3v2lib/types.h

/*
 * This file is part of the id3v2lib library
 *
 * Copyright (c) 2013, Lorenzo Ruiz
 *
 * For the full copyright and license information, please view the LICENSE
 * file that was distributed with this source code.
 */

#ifndef id3v2lib_types_h
#define id3v2lib_types_h

#include "id3v2lib/constants.h"


typedef struct
{
    char tag[ID3_HEADER_TAG];
    char major_version;
    char minor_version;
    char flags;
    int tag_size;
    int extended_header_size;
} ID3v2_header;

typedef struct
{
    int size;
    char encoding;
    char* data;
} ID3v2_frame_text_content;

typedef struct
{
    char* language;
    ID3v2_frame_text_content* text;
} ID3v2_frame_comment_content;

typedef struct
{
    char encoding;
    char* mime_type;
    char picture_type;
    char* description;
    int picture_size;
    size_t offset;
} ID3v2_frame_apic_content;

typedef struct
{
    char frame_id[ID3_FRAME_ID];
    int size;
    char flags[ID3_FRAME_FLAGS];
    size_t offset; // offset in the original file
} ID3v2_frame;

typedef struct _ID3v2_frame_list
{
    ID3v2_frame* frame;
    struct _ID3v2_frame_list* start;
    struct _ID3v2_frame_list* last;
    struct _ID3v2_frame_list* next;
} ID3v2_frame_list;

typedef struct
{
    ID3v2_header* tag_header;
    ID3v2_frame_list* frames;
    File* file;
} ID3v2_tag;

// Constructor functions
ID3v2_header* new_header();
ID3v2_tag* new_tag();
ID3v2_frame* new_frame();
ID3v2_frame_list* new_frame_list();
ID3v2_frame_text_content* new_text_content(int size);
ID3v2_frame_comment_content* new_comment_content(int size);
ID3v2_frame_apic_content* new_apic_content();

void free_tag(ID3v2_tag* tag);
void free_text_content(ID3v2_frame_text_content* content);
void free_comment_content(ID3v2_frame_comment_content* content);
void free_apic_content(ID3v2_frame_apic_content* content);

#endif
