zephray/Bric/(commit log)

2020-03-10 finish sch rev 0.1
    [audio.sch, cpu.sch, keypad.sch, lcd.sch, pcb.sch, power.sch, storage.sch, usb.sch]
2020-03-11 assign footprints
    [audio.sch, lcd.sch, power.sch]
2020-03-15 rev 0.1
    [audio.sch, cpu.sch, keypad.sch, lcd.sch, pcb.kicad_pcb, power.sch, storage.sch, usb.sch]
2020-03-19 pcb: rename keypad signal names
    [cpu.sch, keypad.sch, pcb.kicad_pcb]
2020-03-24 pcb: bug fixes
    [audio.sch, cpu.sch, lcd.sch, pcb.kicad_pcb, power.sch]
2020-03-30 pcb: rev 0.2
    [audio.sch, cpu.sch, pcb.kicad_pcb, power.sch, storage.sch, usb.sch]
2020-04-11 rename original fw framework to bringup
2020-04-21 start implementing power management and tag display
2020-07-26 pcb: rev 0.3
    [audio.sch, lcd.sch, pcb.kicad_pcb, storage.sch]
2021-11-30 fw: initial input and power management framework; linux sim catchup
2021-11-30 fw: initial file browser; target dummy power lib; target lib fixes
    [app.c, decoder.c, ffconf.h, firmware.c, hal_display.c, hal_filesystem.c, hal_input.c, hal_input.h]
2021-12-04 fw: support wav playback; support 32b sample in linux
